PingguSoft/Mostly-Printed-CNC/doc/elec/ramps/ramps-1.4-schema-1920px.jpg

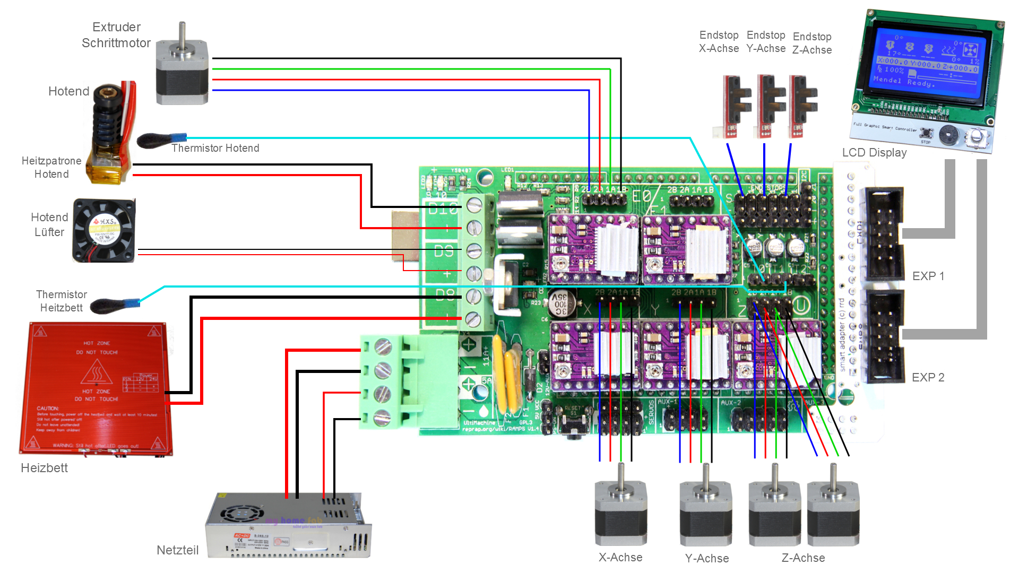
doc/elec/ramps/ramps-1.4-schema-1920px.jpg
