PingguSoft/Mostly-Printed-CNC/doc/Optimized-20151126_212913.jpg

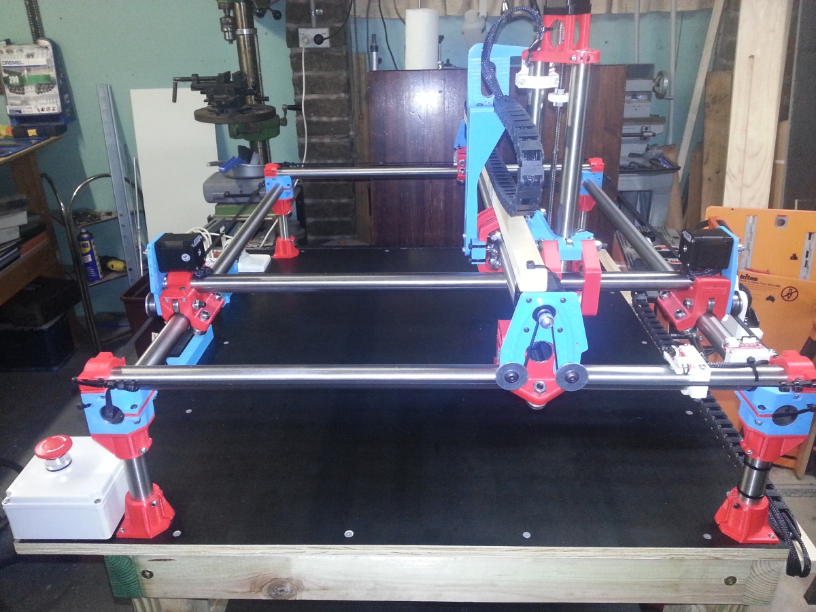
doc/Optimized-20151126_212913.jpg
