PingguSoft/Mostly-Printed-CNC/doc/corner.png

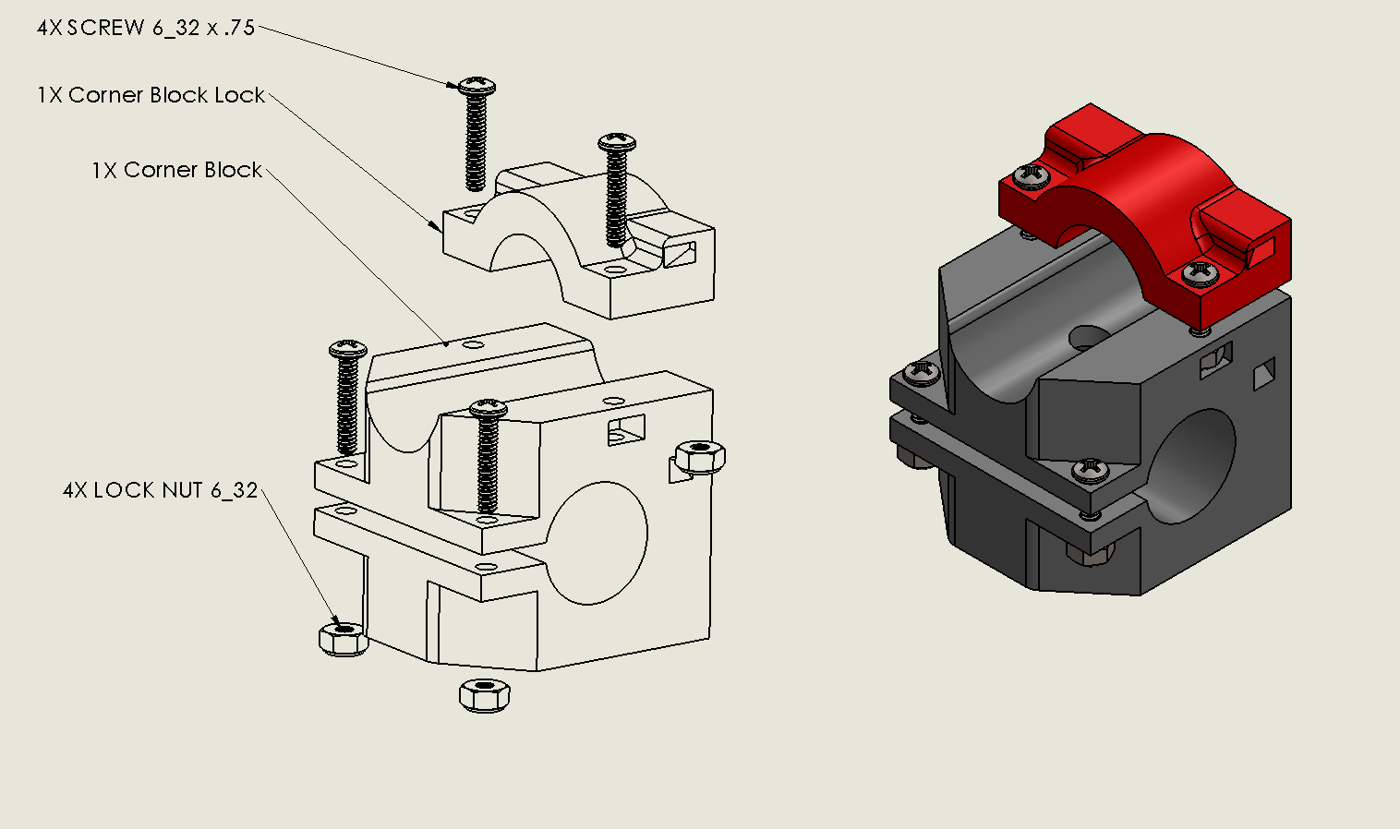
doc/corner.png
