PingguSoft/Mostly-Printed-CNC/doc/elec/laser/Elabz_TTL_Controlled_Laser_Driver.png

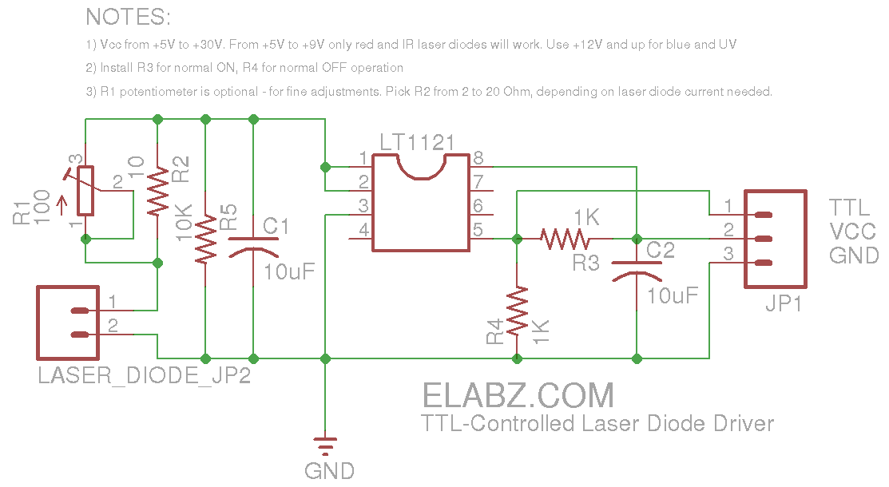
doc/elec/laser/Elabz_TTL_Controlled_Laser_Driver.png
