PingguSoft/Mostly-Printed-CNC/doc/elec/laser/laser driver2.gif

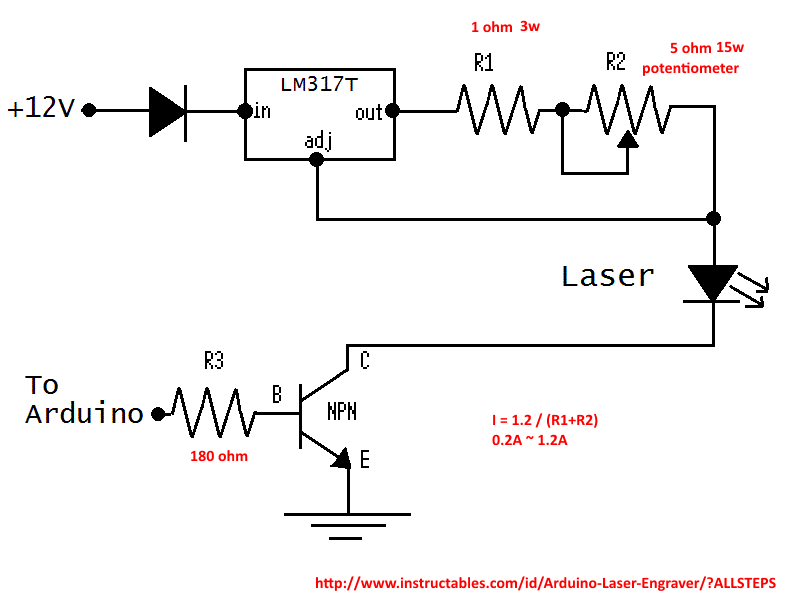
doc/elec/laser/laser driver2.gif
