PingguSoft/Mostly-Printed-CNC/doc/elec/laser/lm317.jpg

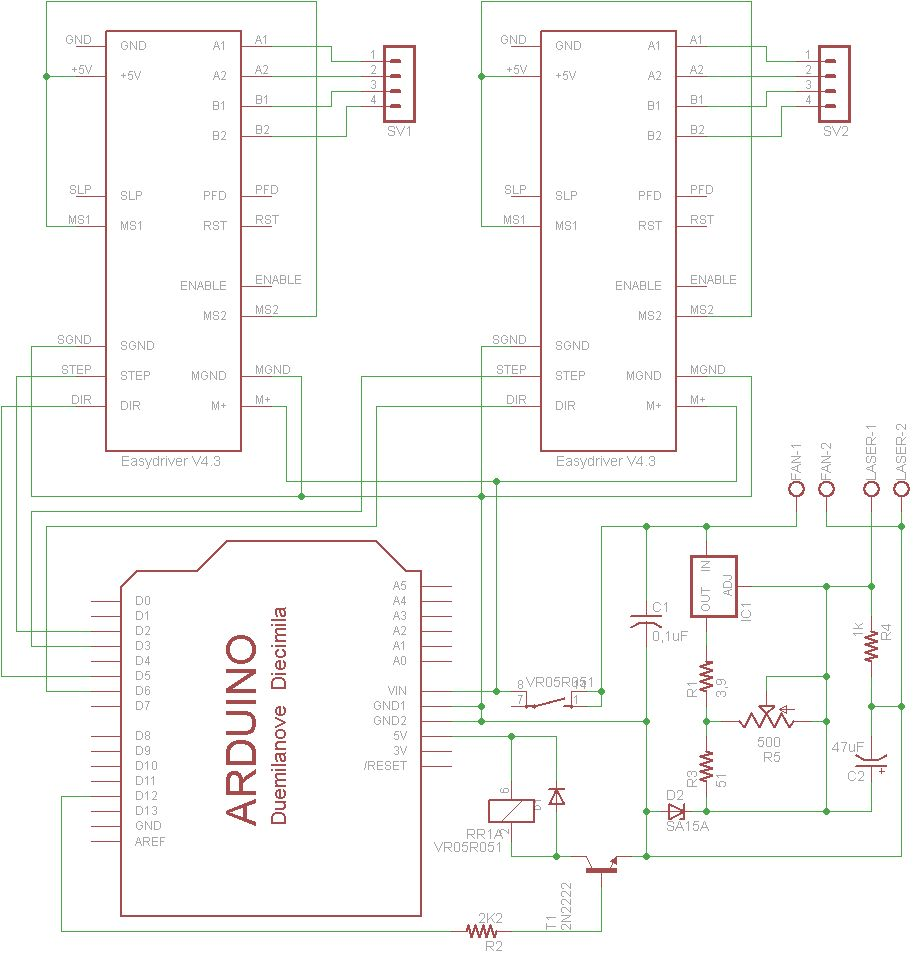
doc/elec/laser/lm317.jpg
