PingguSoft/Mostly-Printed-CNC/doc/elec/laser/Ramps-D9-voltage-divider-12v-to-4.94v-.jpg

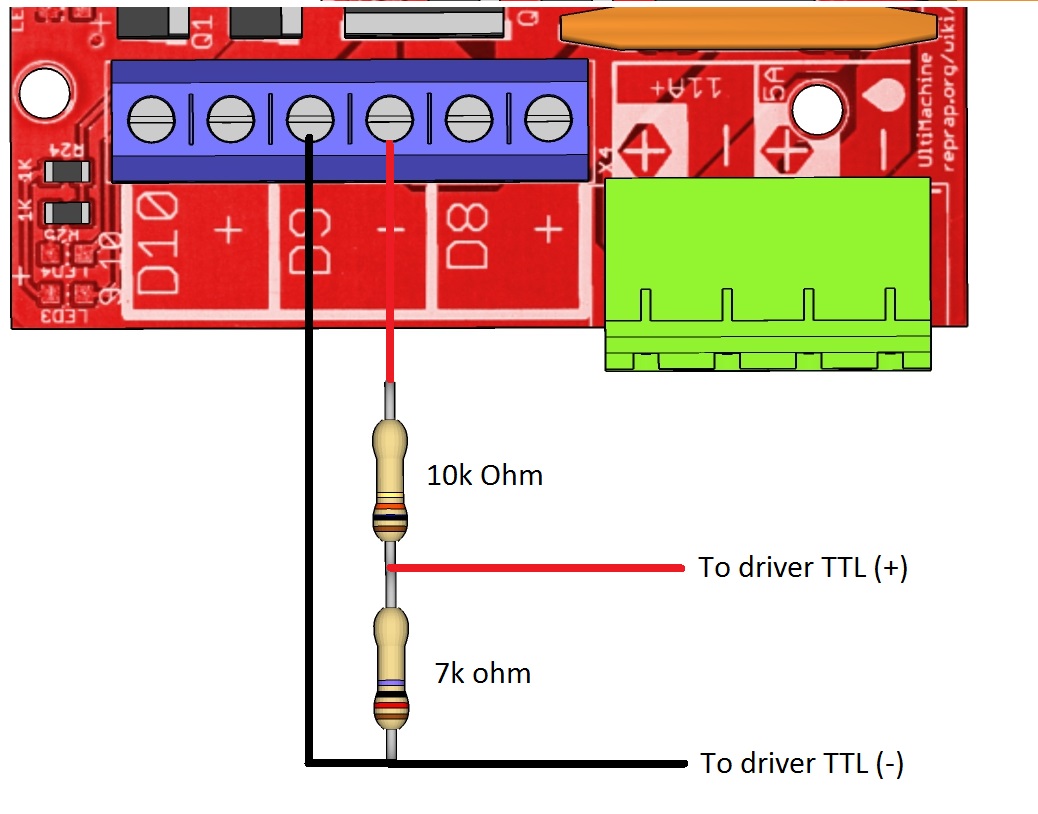
doc/elec/laser/Ramps-D9-voltage-divider-12v-to-4.94v-.jpg
