PingguSoft/Mostly-Printed-CNC/doc/elec/ramps/Motors_serial_connection.jpg

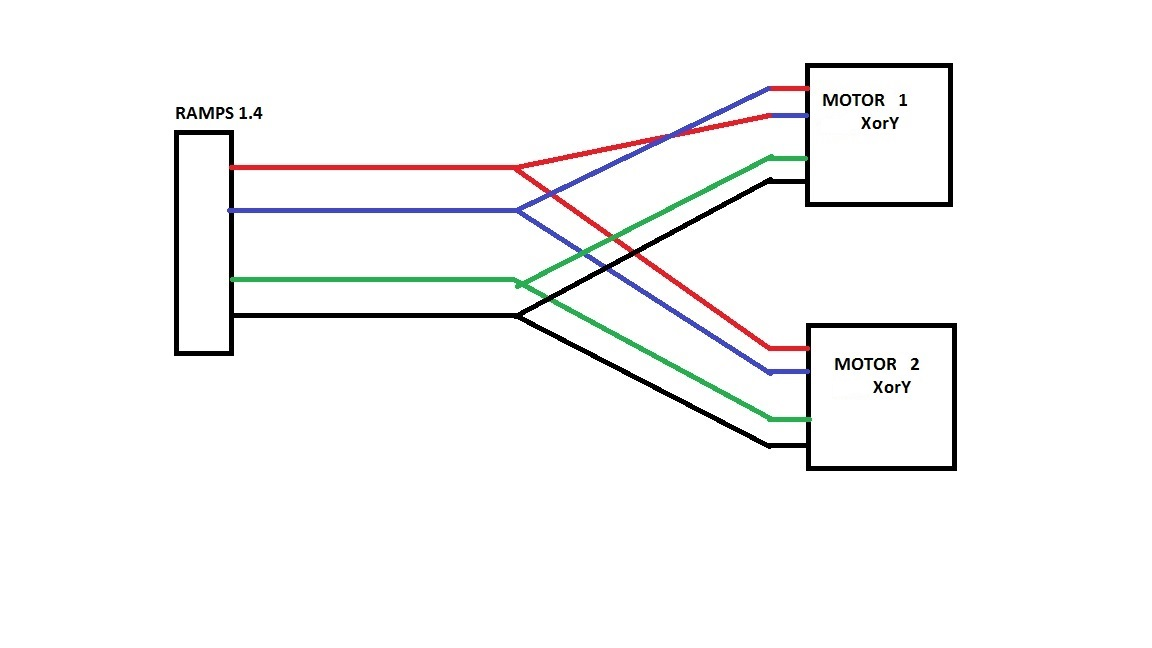
doc/elec/ramps/Motors_serial_connection.jpg
