PingguSoft/Mostly-Printed-CNC/doc/elec/ramps/ramps-1.4-connection.jpg

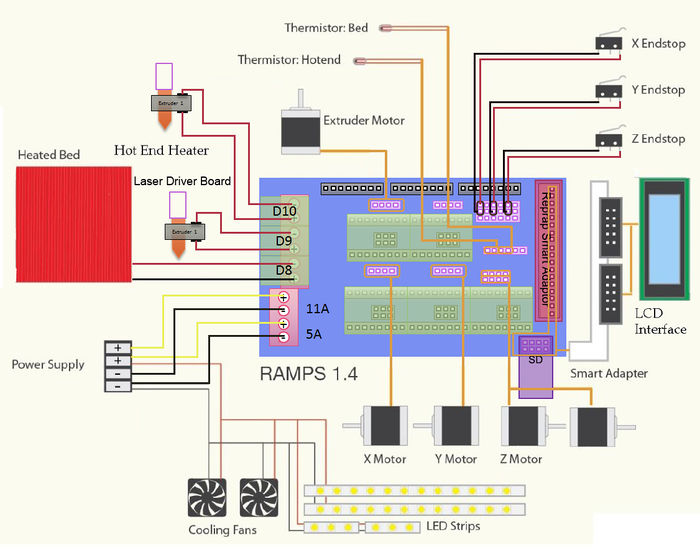
doc/elec/ramps/ramps-1.4-connection.jpg
