PingguSoft/Mostly-Printed-CNC/doc/IMG_20151024_192704.jpg

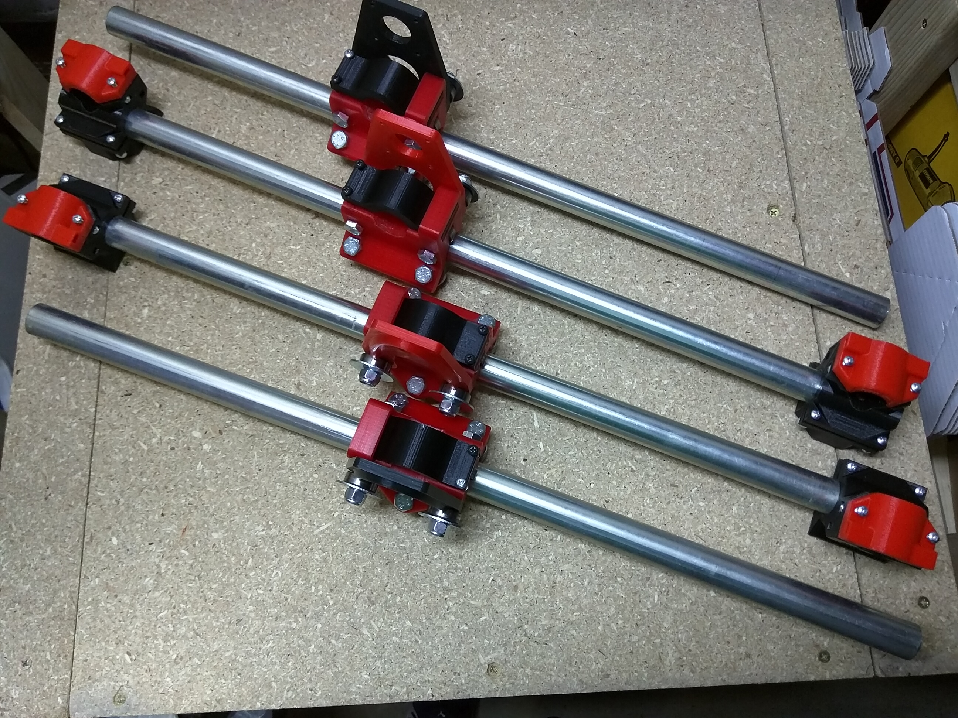
doc/IMG_20151024_192704.jpg
