PingguSoft/Mostly-Printed-CNC/doc/Milling1.jpg

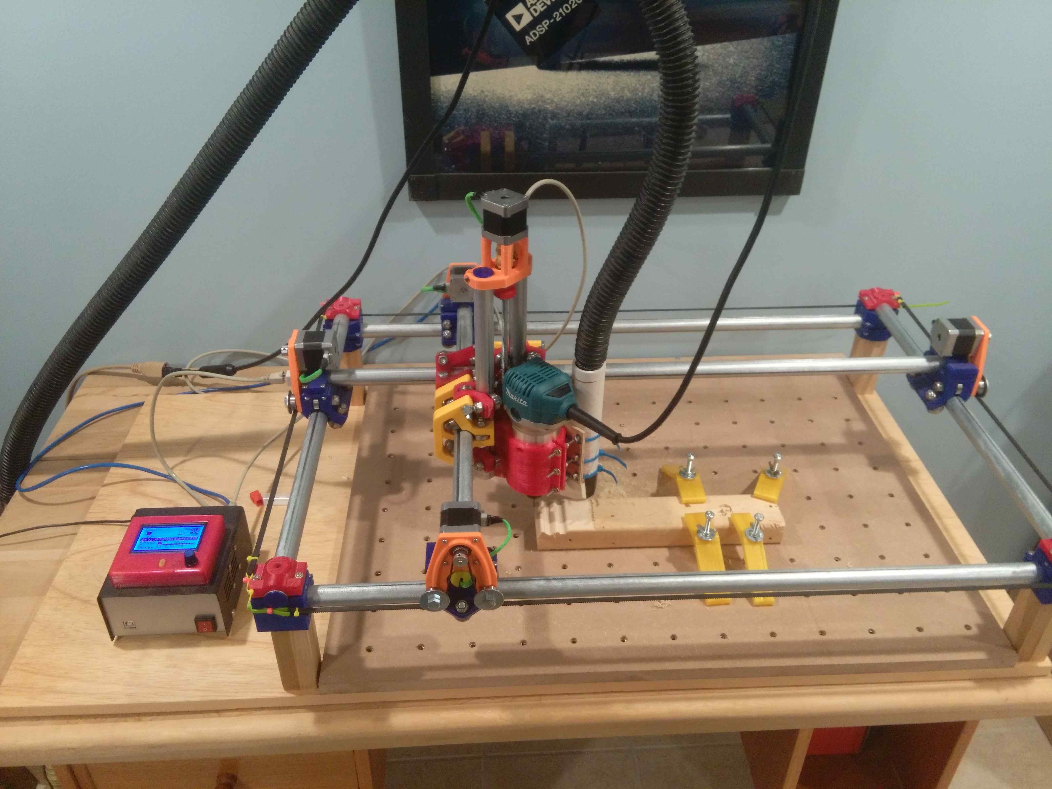
doc/Milling1.jpg
