PingguSoft/Mostly-Printed-CNC/doc/Optimized-20151126_212854.jpg

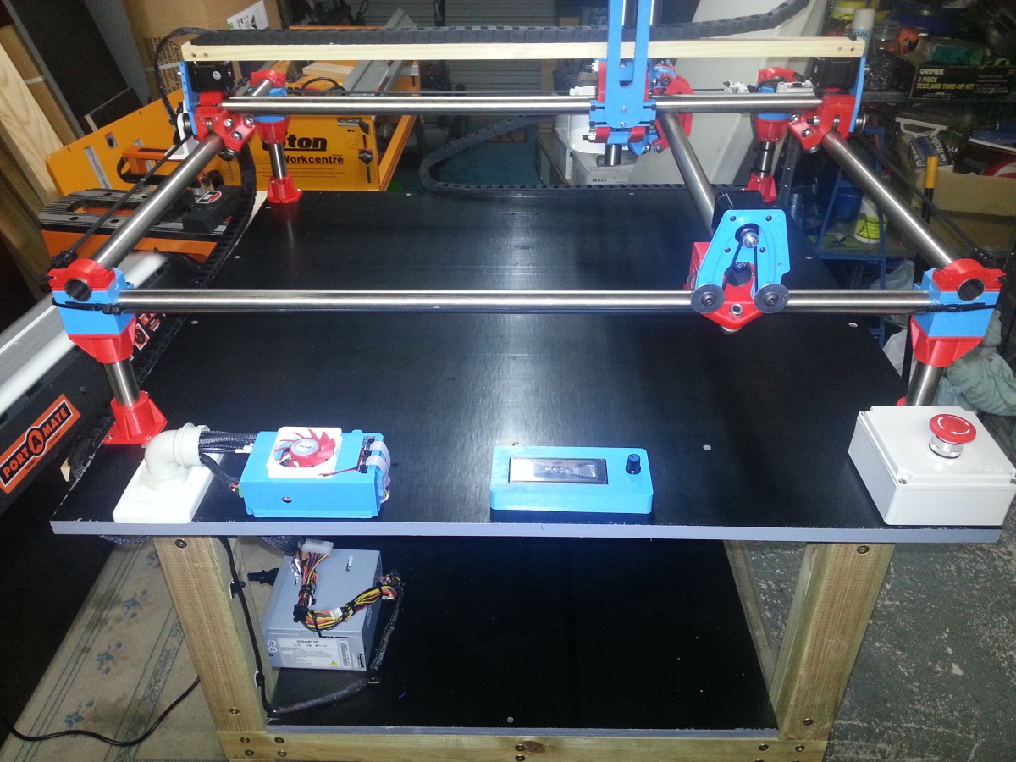
doc/Optimized-20151126_212854.jpg
