PingguSoft/Mostly-Printed-CNC/doc/Optimized-20151126_212932.jpg

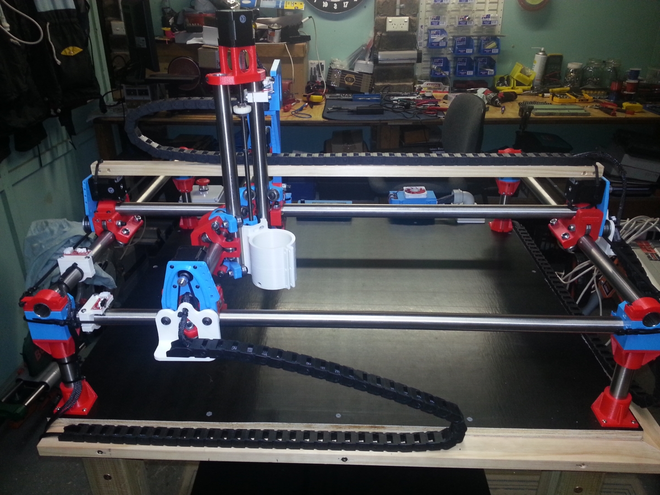
doc/Optimized-20151126_212932.jpg
