PingguSoft/Mostly-Printed-CNC/doc/Optimized-20151126_212954.jpg

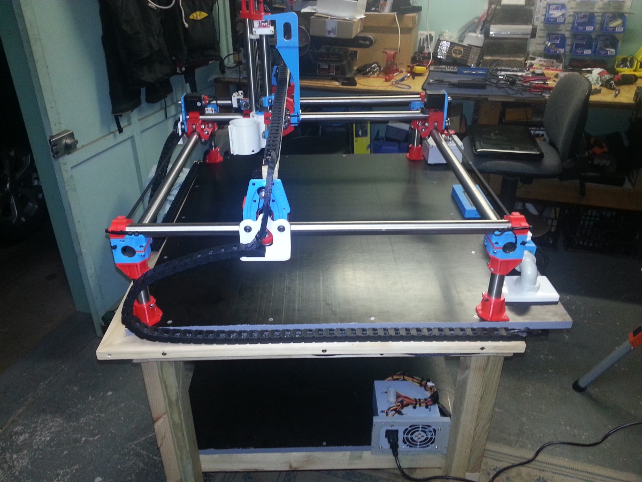
doc/Optimized-20151126_212954.jpg
