PingguSoft/Mostly-Printed-CNC/doc/roller.png

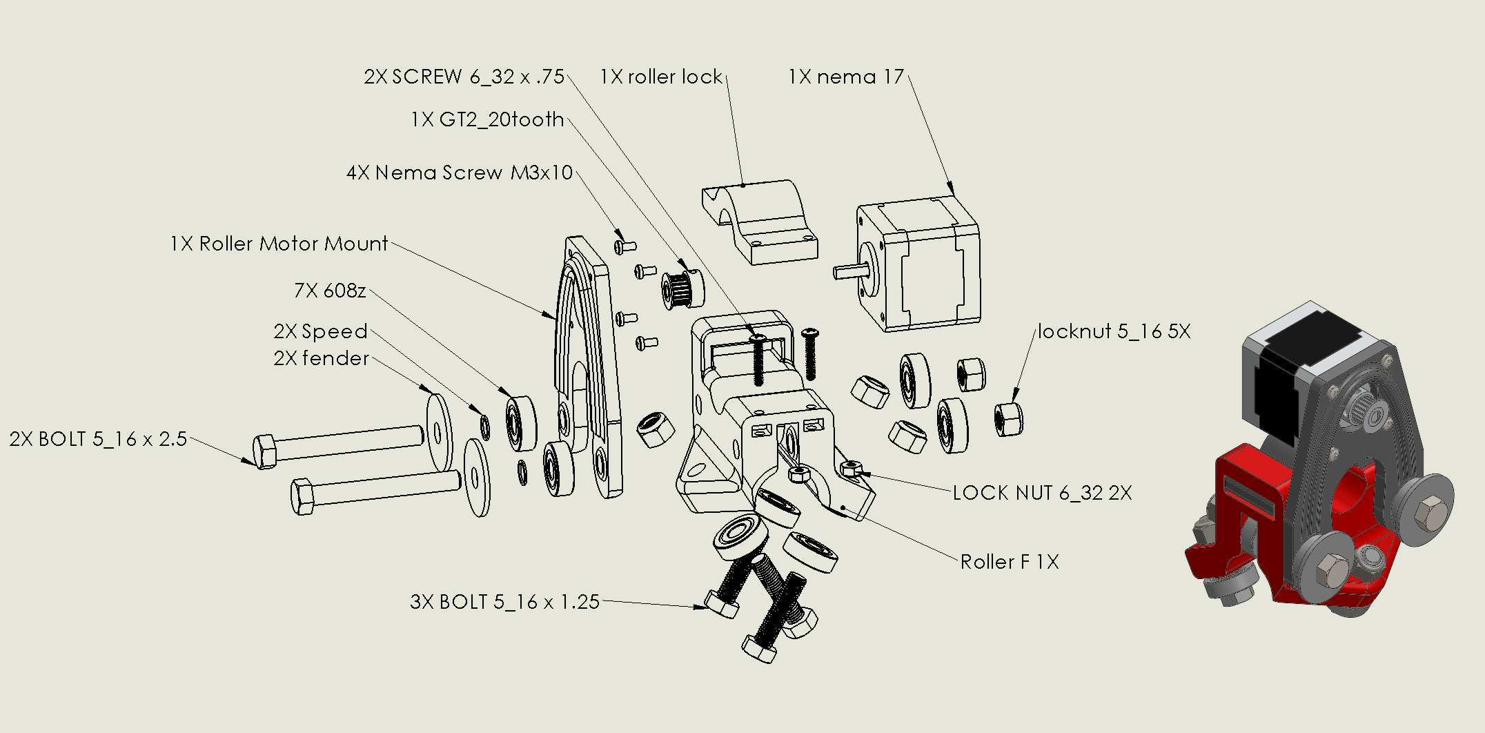
doc/roller.png
