PingguSoft/Mostly-Printed-CNC/doc/parts.xlsx

Sheet: Printed Parts
Recommended; PLA for dimension accuracy, 3 perimeters for through hole strength. I have a .4mm nozzle and print at .26mm layer height, just personal preference. I do print slow for strength, so your prints could be faster.
BLOCK | Name | QTY | Infill | 25mm Link | STL FILE | Printed
CORNER | Corner_Block2 | 4 | 40% | Link (http://www.thingiverse.com/thing:790533/) | IE_Corner_Block2.STL | V | 40%
 | Corner_Block_Lock2 | 4 | 70% | Link (http://www.thingiverse.com/thing:790533/) | IE_Corner_Block_Lock_2.STL | V | 40%
ROLLER | Roller F | 4 | 55% | Link (http://www.thingiverse.com/thing:790533/) | IE_Roller_F_25.stl | V | 40%
 | Roller Lock | 4 | 70% | Link (http://www.thingiverse.com/thing:790533/) | IE_roller_lock_25.stl | V | 40%
 | Solder-less Mount | 4 | 70% | Link (http://www.thingiverse.com/thing:823301/) | solderless_Roller_Motor_Mount.STL | V | 30%
MIDDLE | Better Middle Z | 2 | 75% | Link (http://www.thingiverse.com/thing:931550) | IE_Middle_Z_rigid_v2.STL | V | 40%
 | Middle Joiner | 2 | 70% | Link (http://www.thingiverse.com/thing:790533/) | IE_Middle_Joiner_25_V2.STL | V | 40%
 | Middle End | 2 | 70% | Link (http://www.thingiverse.com/thing:790533/) | IE_Middle_End_25_v2.STL | V | 40%
 | Z Nut Lock | 1 | 70% | Link (http://www.thingiverse.com/thing:790533) | IE_z_nut_lock_13mm.stl | V | 50%
Z Mount | Nut Trap | 2 | 50% | Link (http://www.thingiverse.com/thing:790533) | IE_Tool_Holder_Nut_Trap_25.stl | V | 50%
 | Z Motor Mount | 1 | 60% | Link (http://www.thingiverse.com/thing:806241) | IE_z_motor_mount_10mm_longer_25mm.STL | V | 40%
 | Z Knob | 1 | 50% | Link (http://www.thingiverse.com/thing:729919/) | Z_Knob.stl | V | 40%
 | ~~Rigid Coupler~~ | ~~1~~ | ~~70%~~ | ~~Link~~ (http://www.thingiverse.com/thing:790533/) | ~~IE_Rigid_Coupler_5_16_to_8mm.STL~~
 | Nasspop Coupler 5x8 | 1 |  | Link (http://nasspop.co.kr/product/detail.html?product_no=79&cate_no=85) | Rigid Coupler 대체 | V
FOOT | Flex Foot | 4 | 60% | Link (http://www.thingiverse.com/thing:902483/) | IE-Flex_Foot.STL | V | 40%
 | Foot Bottom | 4 | 60% | Link (http://www.thingiverse.com/thing:902483/) | IE_Foot_Bottom.stl | V | 40%
ETCS | Belt clip | 8 | 40% | Link (http://www.thingiverse.com/thing:1272787) | riemenhalter.stl | V | 30%
 | End stops | 1 | 40% | Link (http://www.thingiverse.com/thing:1090453) | IE25mm-A-endstops_XY.stl IE25mm-B-endstops_Z.stl | V | 30%
 | RepRapDiscount Full Graphic Smart Controller | 1 | 40% | Link (http://www.thingiverse.com/thing:617468) | mods_for_display_case_button.stl | V | 30%
 |  | 1 | 40% | Link (http://www.thingiverse.com/thing:617468) | mods_for_display_case_front.stl | V | 30%
 |  | 1 | 40% | Link (http://www.thingiverse.com/thing:617468) | mods_for_display_case_back.stl | V | 30%
 | drag chain holder for XY-axis | 1 | 50% | Link (http://www.thingiverse.com/thing:1272581) | MPCNCdragchain.stl | V | 30%
 | drag chain / cable carrier for Z axis | 1 | 50% | Link (http://www.thingiverse.com/thing:1296042) | MPCNCdragchainXclip.stl | V | 30%
 |  | 1 | 50% |  | MPCNCdragchainZclip.stl | V | 30%
 |  | 1 | 50% |  | MPCNCdragchainZshelf.stl | V | 30%
UNIVERSAL MOUNT & TOOL HOLDER (HicWic) | ~~Tool Holder V2~~ | ~~2~~ | ~~70%~~ | Link (http://www.thingiverse.com/thing:790533) | IE_Tool_Holder_13mm_25.stl
 | Universal Mount | 1 | 70% | Link (http://www.thingiverse.com/thing:1234989) | IE_Universal_Mount_v5.stl | V | 40%
 | Pen Holder | 1 | 70% | Link (http://www.thingiverse.com/thing:1235003) | Pen_Holder_v4.stl | V | 30%
 |  | 1 | 70% | Link (http://www.thingiverse.com/thing:1235003) | Pen_Adapter_10.5mm.stl | V | 30%
 | MK8 Holder | 1 | 70% | Link (http://www.thingiverse.com/thing:1237075) | TKY_MPCNC_UniversalMount_Mk8_slider.stl
 |  | 1 | 70% |  | TKY_MPCNC_UniversalMount_Mk8_bracket.stl | V | 40%
 |  | 1 | 70% |  |  | V | 40%
 | Dremel 300 Holder | 1 | 70% | Link (http://www.thingiverse.com/thing:1236957) | Dremel300_UpperBracket.stl
 |  | 1 | 70% |  | Dremel300_Bottom_w_Mount.stl
 | Laser holder | 1 | 70% |  | holder.stl | V | 40%
 | Roland Drag Knife Holder | 1 | 70% | Link (http://www.thingiverse.com/thing:1252975)

Sheet: Electronics & Motion Parts
Part | Link | Qty | unit price | Price | Purchased | Price | Remark
Ramps 1.4 Shield | http://nasspop.co.kr/product/detail.html?product_no=75&cate_no=63&display_group=1 | 1 | ₩8500 | ₩8500 | 0 | ₩0 | reused
Arduino Mega 2560 | http://nasspop.co.kr/product/detail.html?product_no=77&cate_no=63&display_group=1 | 1 | ₩15000 | ₩15000 | 0 | ₩0 | reused
DRV8825 Drivers + Heat Sinks | http://nasspop.co.kr/product/detail.html?product_no=103&cate_no=63&display_group=1 | 4 | ₩2900 | ₩11600 | 3 | ₩8700 | reused
12v 5A power supply | http://nasspop.co.kr/product/detail.html?product_no=132&cate_no=75&display_group=1 | 1 | ₩14000 | ₩14000 | 0 | ₩0 | reused
GT2 belt (4M = 24″x24″) | http://nasspop.co.kr/product/detail.html?product_no=25&cate_no=71&display_group=1 | 4 | ₩1500 | ₩6000 | 4 | ₩6000
GT2 16T Pulley | http://nasspop.co.kr/product/detail.html?product_no=26&cate_no=71&display_group=1 | 4 | ₩1500 | ₩6000 | 4 | ₩6000
608 Bearings (2-RS, Z, ZZ) | http://nasspop.co.kr/product/detail.html?product_no=47&cate_no=72&display_group=1 | 60 | ₩200 | ₩12000 | 60 | ₩12000
Conduit 3/4″ emt (23.5mm OD, IE version 25mm OD) | http://www.11st.co.kr/product/SellerProductDetail.tmall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 | 1 | ₩23400 | ₩23400 | 1 | ₩23400
Nema 17 Steppers | http://nasspop.co.kr/product/detail.html?product_no=18&cate_no=62&display_group=1#none | 5 | ₩15500 | ₩77500 | 3 | ₩46500 | 2 reused
12864 GLCD | http://nasspop.co.kr/product/detail.html?product_no=89&cate_no=63&display_group=1 | 1 | ₩15000 | ₩15000 | 1 | ₩15000
Resistor 100 ohm
Stranded Shielded 4 Wire |  | ≅15ft
DuPont connectors (3×4 & 1×2) |  | 4
Zip Ties |  | ≥20
 |  |  |  | ₩189000 |  | ₩117600
Spindle Options
Dewalt 660 (Beast!) | http://amzn.to/1VyeDY6 | 1
or Dremel 300 |  | 1 |  |  | 0 |  | reused
3D Printer Options
3D printer extruder | http://www.aliexpress.com/item/12-24V-Fan-3D-Printer-head-Makerbot-3D-Printer-single-exturder-MK8-Extruder-Free-Shipping/1987122502.html | 1 | ₩31536 | ₩31536 | 1 | ₩31536
Laser Options
500mw 405NM focusing blue purple laser module laser engraving TTL module | http://www.aliexpress.com/item/500mw-405NM-focusing-blue-purple-laser-module-laser-engraving-TTL-module-500mw-laser-tube-Laser-module/32562052620.html | 1 | ₩46200 | ₩46200 | 0 | ₩0
Roland Drag Knife Options
Gcc Sign pal Vinyl Cutter Blade Holder + 5 pcs 45 + 5 pcs 60 Degree | http://www.aliexpress.com/item/1pc-Gcc-Signpal-Vinyl-Cutter-Blade-Holder-5-pcs-45-5-pcs-60-Degree-Roland-Liyu/32336073909.html | 1 | ₩20388 | ₩20388 | 0 | ₩0
 |  |  |  | ₩98124 |  | ₩31536
 |  |  | TOTAL | ₩287124 |  | ₩149136

Sheet: Hardware
Sort | Imperial | Metric | Link | Qty | Qty/pack | pack | unit price | Price | Purchased |  |  |  |  | 개수
TR | 5/16-18 Threaded Rod | M8 | http://nasspop.co.kr/product/detail.html?product_no=152&cate_no=87&display_group=1 | 1 | 440mm | 1 | ₩1500 | ₩1500 | V |  |  | mm |  |  |  |  |  | Cm | inch
HEX BOLT | 5/16-18 X 3 | M8 X 80 | http://www.11st.co.kr/product/SellerProductDetail.tmall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 | 4 | 7 | 1 | ₩1500 | ₩1500 | V | working area | x | 400 |  |  |  | working area | x | 40 | 15.7480315
 | 5/16-18 X 2.5 | M8 X 70 |  | 8 | 9 | 1 | ₩1500 | ₩1500 | V |  | y | 400 |  |  |  |  | y | 40 | 15.7480315
 | 5/16-18 X 1.75 | M8 X 45 |  | 2 | 10 | 1 | ₩1500 | ₩1500 | V |  | z | 140 |  |  |  |  | z | 25 | 9.842519685
 | 5/16-18 X 1.5 | M8 X 40 |  | 2 | 12 | 1 | ₩1500 | ₩1500 | V
 | 5/16-18 X 1.25 | M8 X 30 |  | 28 | 16 | 2 | ₩3000 | ₩6000 | V | Conduit length | x | 664 |  | 3 | 1992 | Conduit length | x | 67 | 26.37795276 | 3 | 201
WASHER | 5/16 Fender Washers | M8 - 30 | http://www.11st.co.kr/product/SellerProductDetail.tmall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 | 8 | 14 | 1 | ₩1500 | ₩1500 | V |  | y | 664 |  | 3 | 1992 |  | y | 67 | 26.37795276 | 3 | 201
 | SAE(Small washer) or Speed washers | M8 | http://www.11st.co.kr/product/SellerProductDetail.tmall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 | 8 | 55 | 1 | ₩1500 | ₩1500 | V |  | z | 330 |  | 2 | 660 |  | z | 45 | 17.71653543 | 2 | 90
NUTS | 5/16-18 Nylock Nuts | M8 | http://www.11st.co.kr/product/SellerProductDetail.tmall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 | 44 | 25 | 2 | ₩3000 | ₩6000 | V |  | leg | 127 |  | 4 | 508 |  | leg | 25 |  | 4 | 100
 | 5/16-18 nuts (2 for z knob) | M8 |  | 3 | 37 | 1 | ₩1500 | ₩1500 | V |  |  |  |  |  | 5152 |  |  |  |  |  | 592
 | #6-32 Nylock nuts | M4 |  | 36 | 67 | 1 | ₩1500 | ₩1500 | V | Thread | z | 216 | min | ~250 |  | Thread | z | 39.92 | 15.71653543
CROSS BOLT | M3 X 10 | M3 X 10 | http://www.11st.co.kr/product/SellerProductDetail.tmall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 | 20 | 42 | 1 | ₩1500 | ₩1500 | V
 | #6-32 X.75 | M4 X 20 |  | 34 | 20 | 2 | ₩3000 | ₩6000 | V | belt | x | 800 | min | 2 |  |  |  | mm | Cm | 개수
 | #6-32 X .5 for coupler (20 for solderless mounts) | M4 X 16 |  | 22 | 25 | 1 | ₩1500 | ₩1500 | V |  | y | 800 | min | 2 |  | 조인트 차지하는 길이 |  | 27
ETCS | 5/16 x 7/8 coupling nut | M8 X 25 |  | 1 |  | 1 |  |  |  |  |  |  |  |  |  | 지지 파이프 길이 |  | 616 | 62 | 4 | 248
 | Spring 1″X.375″ODx.035″ | M8IDX25mmX.9mm |  | 1 |  | 1 |  |  |  | table | x | 670.5 | min |  |  | leg |  |  | 13 | 4 | 52
CHAINS | drag chain | 10x20mm x 1m | AliExpress (http://www.aliexpress.com/item/10-x-20mm-1M-Open-On-Both-Side-Plastic-Towline-Cable-Drag-Chain-Wonderful-Gift/32244468731.html) | 4 | 1 | 4 | ₩5424 | ₩21696 | V |  | y | 670.5 | min |  |  |  |  |  |  |  | 300
GLASS | tempered glass | 450mmx450mm | http://www.11st.co.kr/product/SellerProductDetail.tmall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 | 1 |  | 1 | ₩9900 | ₩9900 | V
TABLE | MELLTORP 테이블 상판(제품번호: 302.800.99) | 750mmx750mm | http://www.ikea.com/kr/ko/catalog/products/30280099/ | 1 |  | 1 | ₩19900 | ₩19900 | V
PIPE JOINT | L 형 조인트 |  | http://www.11st.co.kr/product/SellerProductDetail.tmall?method=getSellerProductDetail&prdNo=1300741891 | 4 |  |  | ₩3710 | ₩14840
 | 원형 롱소켓 |  |  | 4 |  |  | ₩1710 | ₩6840
 | 돔형 마감캡 |  |  | 12 |  |  | ₩500 | ₩6000
SUPPORT | 지지 파이프 | 25mm | http://www.11st.co.kr/product/SellerProductDetail.tmall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
 |  |  |  |  |  |  |  | ₩113676

Sheet: Connector
MODULE | PART | PIN | POWER | OTHERS
3D Printer Extruder | Stepper Motor | 4 | 4 | 6 | 1 | 2 | 3 | 4 | 5 | 6 | 7 | 8 | 9 | 10 | 1 | 2 | 3 | 4 | 5 | 6
 | Thermal sensor | 2 |  |  | E-STP1 | E-STP2 | E-STP3 | E-STP4 | N-Therm | N-Therm | Z-END |  |  |  | +12V PC | +12V HC | +12V AO | 5V |  | GND
 | 12V AO(always on, 5A) for barrel FAN | 1 |  |  | 오렌지 | 옅은녹색 | 녹색 | 흰색 | 갈색 | 연한갈색 | 연한파랑 |  |  |  | 녹색 | 파랑 | 보라 | 파랑 |  | 회색
 | 12V PC(pwm controlled) for hotend FAN | 1 |  |  |  |  |  |  |  |  | active high
 | 12V HC for hotend | 1 |  |  | Cat-6 | twisted
 | GND | 1
Laser | 12V AO(always on, 5A) | 1 | 2 | 1
 | GND | 1 |  |  | MOLEX 53258-06 |  | MALE | ₩290 | 5 | ₩1450 |  |  | z axis side
 | PWM | 1 |  |  | MOLEX 51067-06 |  | FEMALE | ₩390 | 5 | ₩1950 |  |  | tool side
 |  |  |  |  | 51067 Crimp terminal |  |  | ₩50 | 30 | ₩1500
Z endstop | sensor | 2 | 0 | 2 | MOLEX 5566-06A |  | MALE | ₩510 | 5 | ₩2550 |  |  | Z axis side
 |  |  |  |  | MOLEX 5557-06R |  | FEMALE | ₩210 | 5 | ₩1050 |  |  | tool side
 |  |  |  |  | 5557 Crimp terminal |  |  | ₩50 | 30 | ₩1500
 |  |  |  |  |  |  |  |  |  | ₩10000

Sheet: assemble_cornor_block
https://youtu.be/g01UwQhFxdI

Sheet: assemble_roller
https://youtu.be/mri-6v6uIMo

Sheet: assemble_z_mount
https://youtu.be/Apgp4XfpfwM

Sheet: assemble_middle
http://www.vicious1.com/assembly/middle/
