PingguSoft/Mostly-Printed-CNC/stl/etcs/connector_holder_base.stl

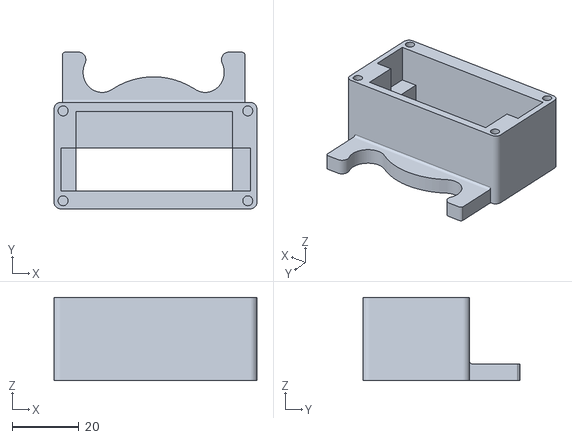
[picture p19: CAD file, 2017-01-20]
stl/etcs/connector_holder_base.stl
61.0 x 47.1 x 25.0
