PingguSoft/Mostly-Printed-CNC/stl/foot/IE-Flex_Foot.STL

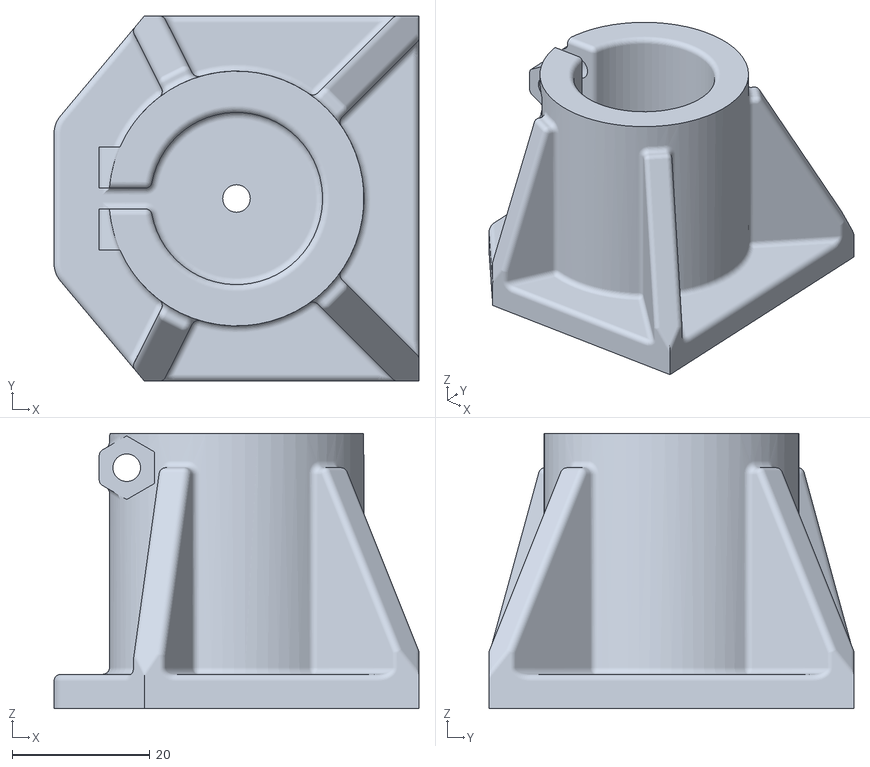
[picture p20: CAD file, 2016-01-13]
stl/foot/IE-Flex_Foot.STL
53.0 x 53.0 x 40.0
