PingguSoft/Mostly-Printed-CNC/stl/IE_Middle_Z_rigid_v2.STL

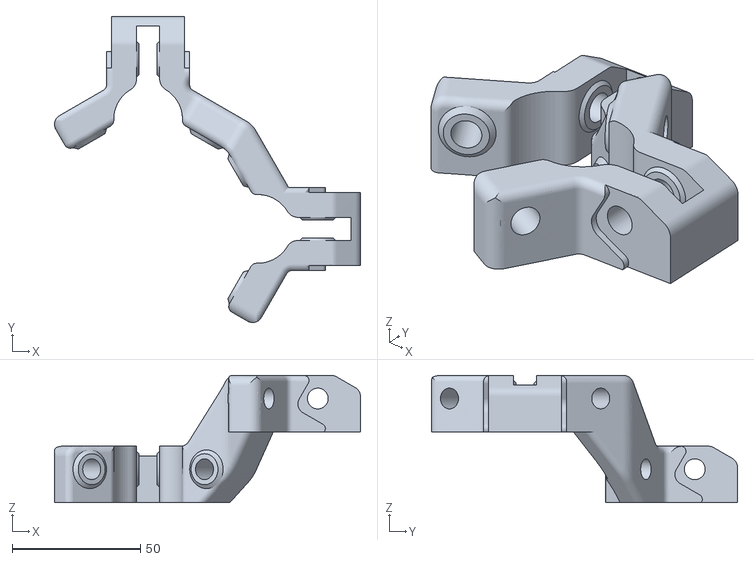
[picture p21: CAD file, 2016-01-13]
stl/IE_Middle_Z_rigid_v2.STL
119.4 x 119.4 x 49.6
