PingguSoft/Mostly-Printed-CNC/stl/spool/pipe_cap_for_25mm.stl

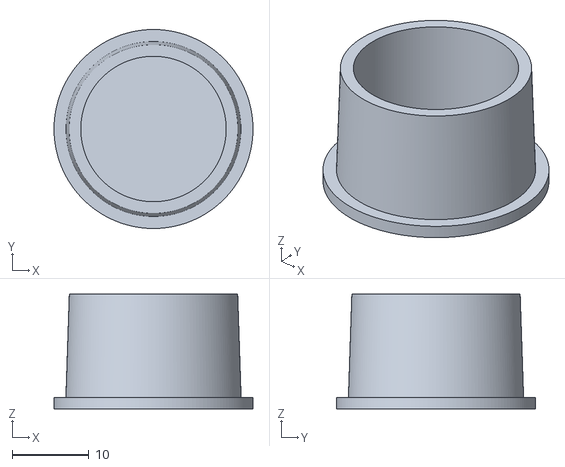
[picture p22: CAD file, 2017-01-20]
stl/spool/pipe_cap_for_25mm.stl
26.0 x 26.0 x 15.0
