PingguSoft/Mostly-Printed-CNC/stl/universal holder/Std_Mini_Mount_v4.stl

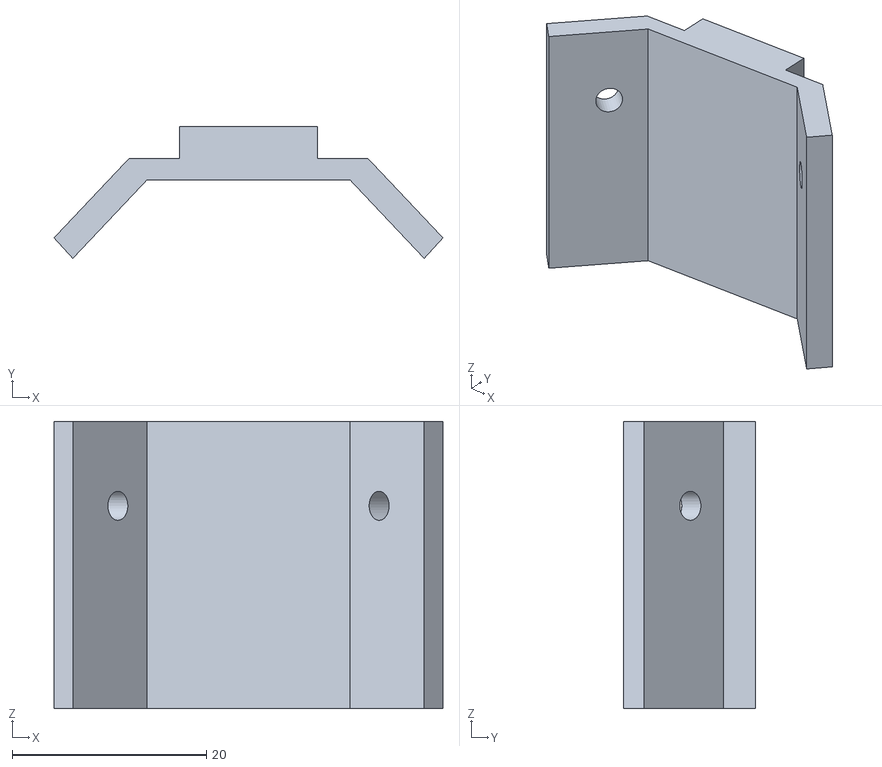
[picture p23: CAD file, 2016-02-04]
stl/universal holder/Std_Mini_Mount_v4.stl
40.1 x 13.6 x 29.6
