PingguSoft/Mostly-Printed-CNC/stl/etcs/sensor_holder_all.stl

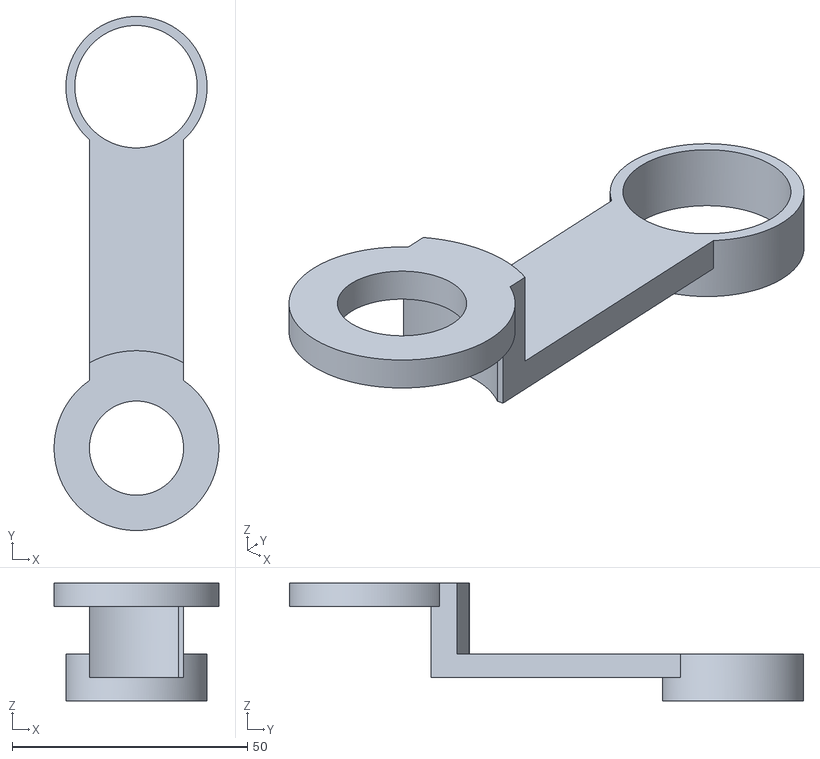
[picture p24: CAD file, 2017-01-20]
stl/etcs/sensor_holder_all.stl
35.0 x 109.2 x 25.0
