PingguSoft/Mostly-Printed-CNC/stl/foot/IE_Foot_Bottom.stl

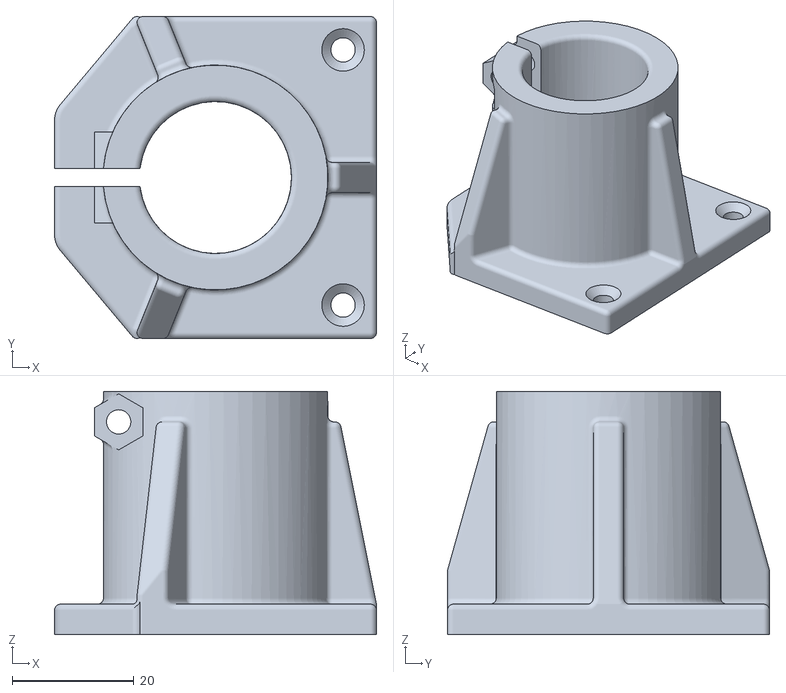
[picture p25: CAD file, 2016-01-13]
stl/foot/IE_Foot_Bottom.stl
53.0 x 53.0 x 40.0
