PingguSoft/Mostly-Printed-CNC/stl/universal holder/Offset10mm_Maxi_Mount_v2.stl

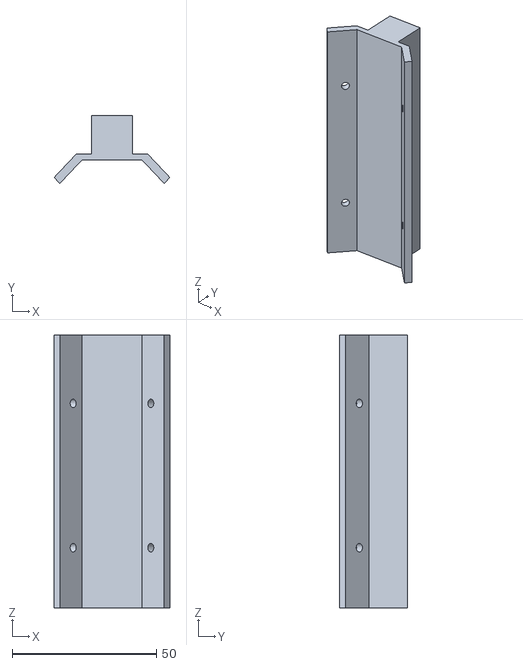
[picture p26: CAD file, 2016-02-04]
stl/universal holder/Offset10mm_Maxi_Mount_v2.stl
40.1 x 23.6 x 94.6
