PingguSoft/Mostly-Printed-CNC/stl/etcs/spool_holder.stl

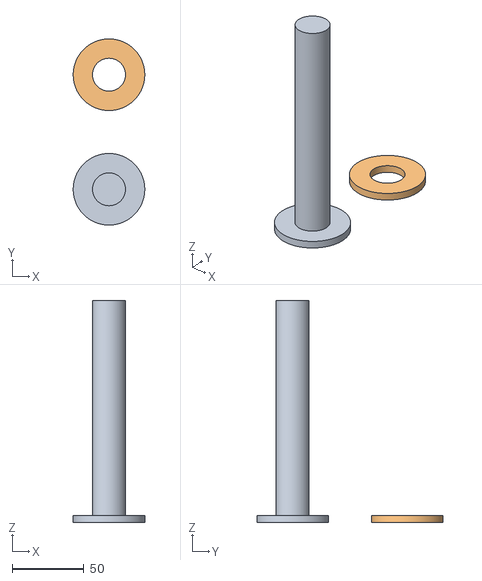
[picture p27: CAD file, 2017-01-20]
stl/etcs/spool_holder.stl
50.0 x 130.0 x 155.0
