PingguSoft/Mostly-Printed-CNC/stl/solderless_Roller_Motor_Mount.STL

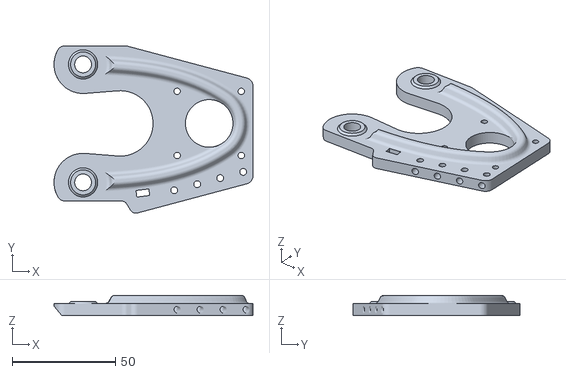
[picture p28: CAD file, 2016-01-13]
stl/solderless_Roller_Motor_Mount.STL
96.1 x 80.9 x 9.84
