PingguSoft/Mostly-Printed-CNC/stl/spool/2016_spool.stl

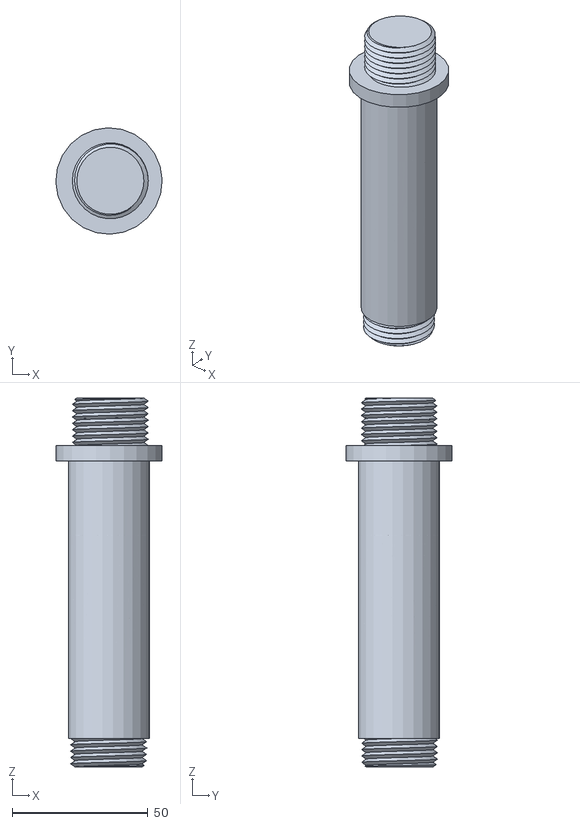
[picture p29: CAD file, 2017-01-20]
stl/spool/2016_spool.stl
39.2 x 39.2 x 135.8
