PingguSoft/Mostly-Printed-CNC/stl/universal holder/Dremel300_UpperBracket.stl

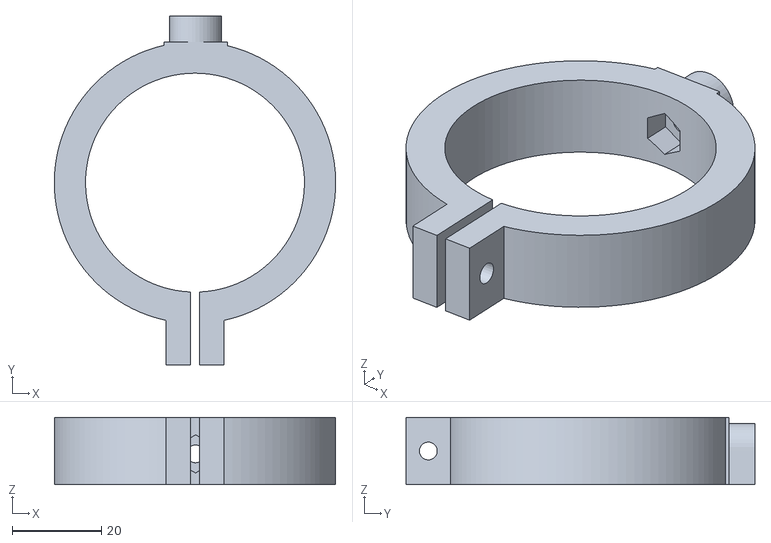
[picture p30: CAD file, 2016-01-22]
stl/universal holder/Dremel300_UpperBracket.stl
63.0 x 78.1 x 15.0
