PingguSoft/Mostly-Printed-CNC/stl/etcs/connector_holder_top.stl

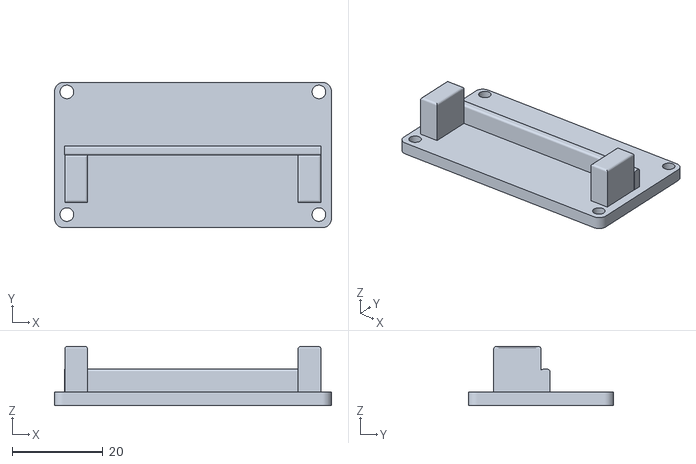
[picture p31: CAD file, 2017-01-20]
stl/etcs/connector_holder_top.stl
61.0 x 32.0 x 13.0
