PingguSoft/Mostly-Printed-CNC/stl/IE_z_motor_mount_10mm_longer_25mm.STL

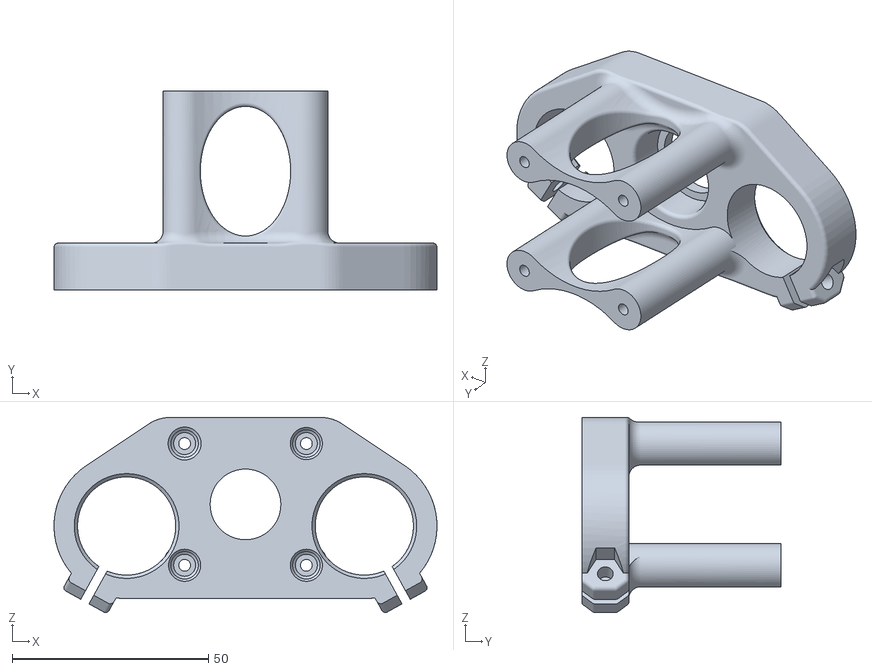
[picture p32: CAD file, 2016-01-13]
stl/IE_z_motor_mount_10mm_longer_25mm.STL
97.5 x 50.8 x 49.7
