PingguSoft/Mostly-Printed-CNC/stl/universal holder/Dremel300_Bottom_w_Mount.stl

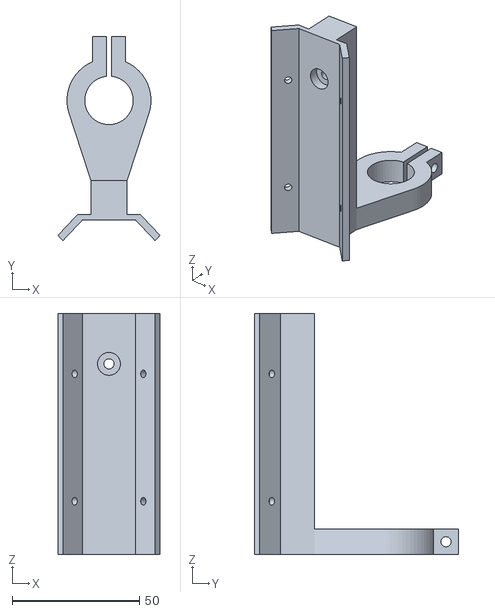
[picture p33: CAD file, 2016-01-22]
stl/universal holder/Dremel300_Bottom_w_Mount.stl
40.1 x 80.3 x 94.6
