PingguSoft/Mostly-Printed-CNC/stl/etcs/Felix_E3DV5_fan_duct_V2.stl

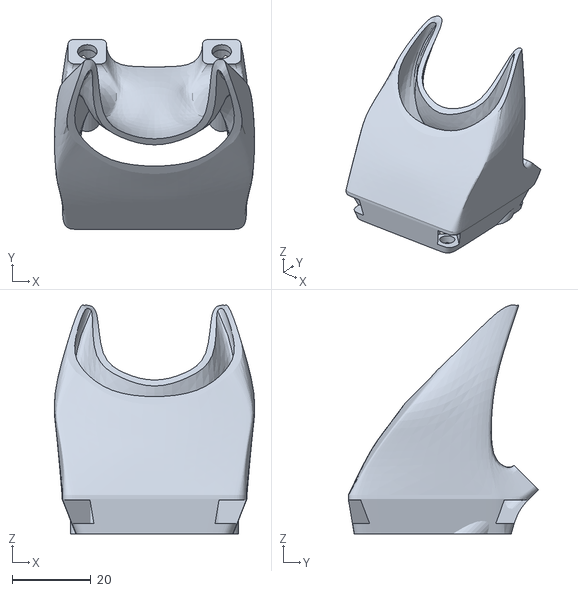
[picture p34: CAD file, 2017-01-20]
stl/etcs/Felix_E3DV5_fan_duct_V2.stl
51.0 x 48.5 x 58.3
