PingguSoft/Mostly-Printed-CNC/stl/universal holder/Pen_Holder_v4.stl

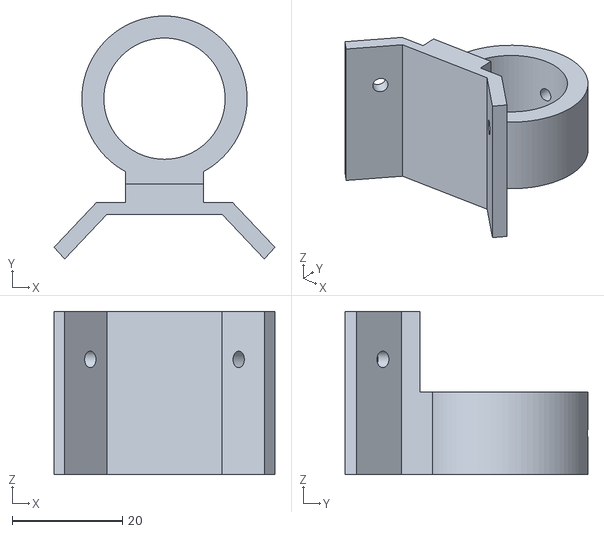
[picture p35: CAD file, 2016-01-20]
stl/universal holder/Pen_Holder_v4.stl
40.1 x 44.1 x 29.6
