PingguSoft/Mostly-Printed-CNC/stl/Z_Knob.STL

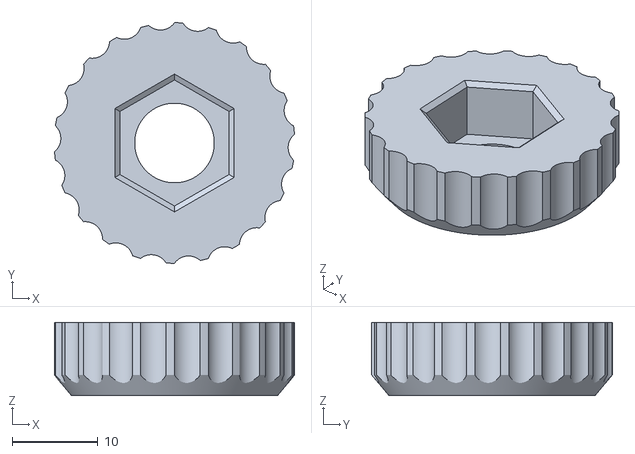
[picture p36: CAD file, 2016-01-13]
stl/Z_Knob.STL
27.9 x 28.0 x 8.50
