PingguSoft/Mostly-Printed-CNC/stl/etcs/mpcnc_square_check_rev1_20160212-15074-5me4b8-0.stl

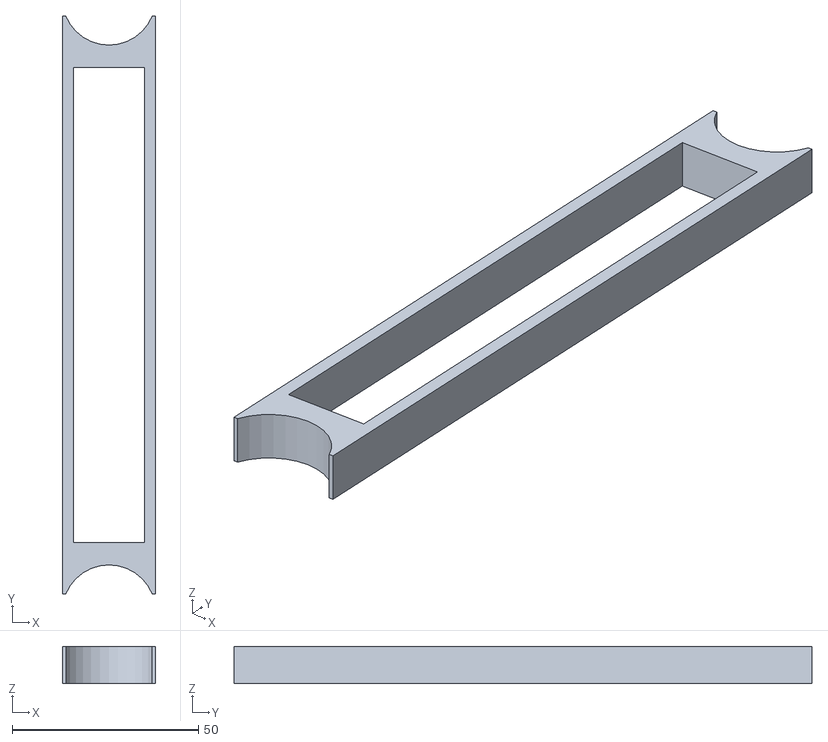
[picture p37: CAD file, 2017-01-20]
stl/etcs/mpcnc_square_check_rev1_20160212-15074-5me4b8-0.stl
25.0 x 155.0 x 10.0
