PingguSoft/Mostly-Printed-CNC/stl/IE_roller_lock_25.stl

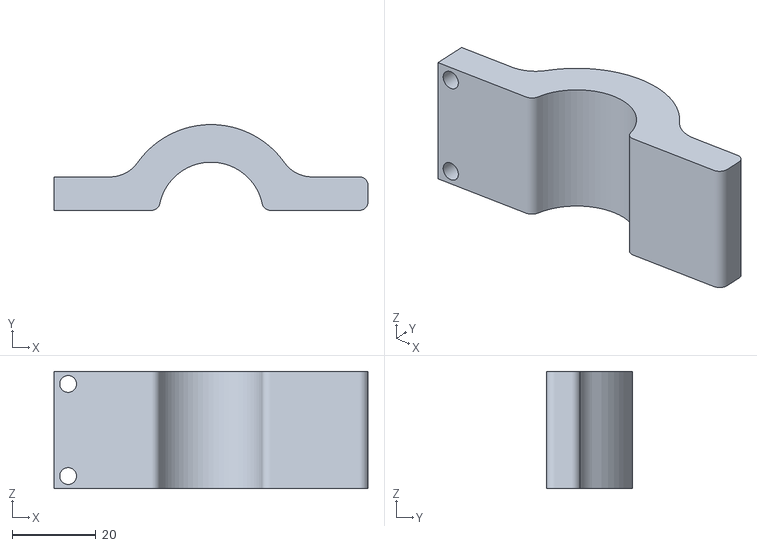
[picture p38: CAD file, 2015-11-30]
stl/IE_roller_lock_25.stl
75.0 x 20.5 x 28.0
