PingguSoft/Mostly-Printed-CNC/stl/universal holder/Pen_Adapter_10.5mm.stl

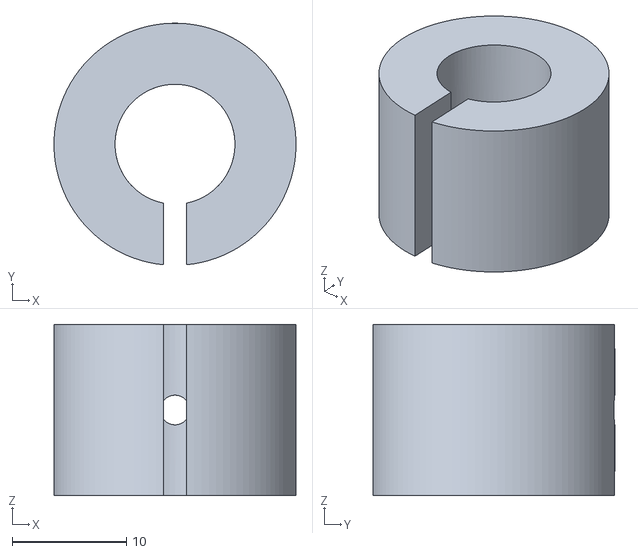
[picture p39: CAD file, 2016-01-20]
stl/universal holder/Pen_Adapter_10.5mm.stl
21.2 x 21.2 x 15.0
