PingguSoft/Mostly-Printed-CNC/stl/etcs/MPCNCdragchainZclip.stl

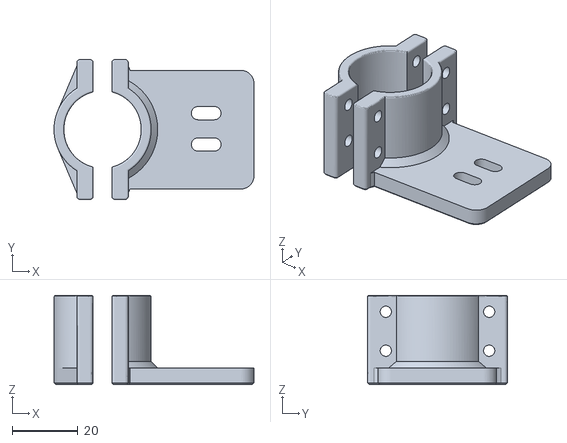
[picture p40: CAD file, 2016-02-14]
stl/etcs/MPCNCdragchainZclip.stl
60.6 x 42.5 x 27.0
