PingguSoft/Mostly-Printed-CNC/stl/IE_Middle_Joiner_25_V2.STL

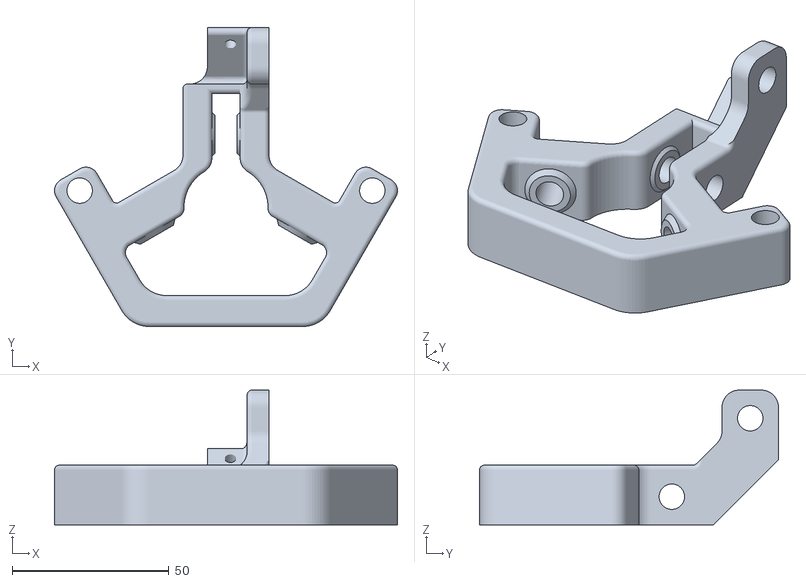
[picture p41: CAD file, 2015-11-30]
stl/IE_Middle_Joiner_25_V2.STL
109.4 x 95.3 x 43.0
