PingguSoft/Mostly-Printed-CNC/stl/universal holder/TKY_MPCNC_UniversalMount_Mk8_slider.stl

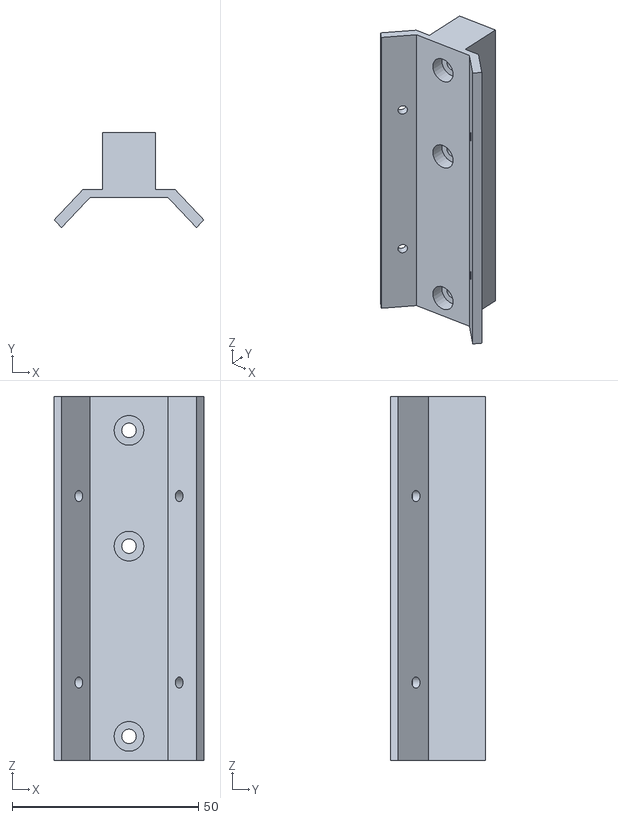
[picture p42: CAD file, 2016-01-20]
stl/universal holder/TKY_MPCNC_UniversalMount_Mk8_slider.stl
40.1 x 25.6 x 97.6
