PingguSoft/Mostly-Printed-CNC/stl/etcs/MPCNCdragchainXclip.stl

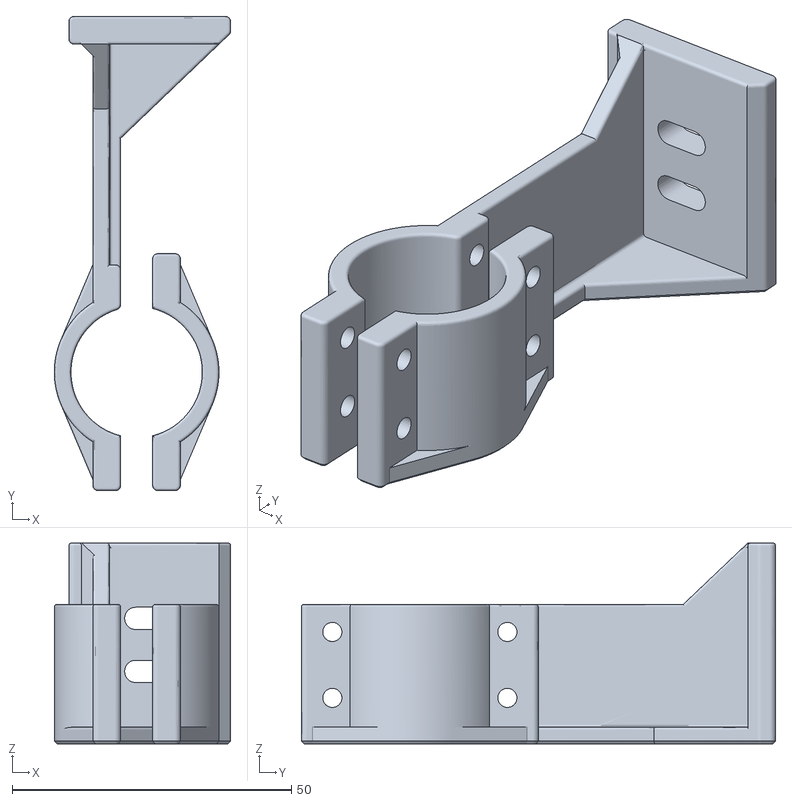
[picture p43: CAD file, 2016-02-14]
stl/etcs/MPCNCdragchainXclip.stl
31.6 x 85.0 x 36.0
