PingguSoft/Mostly-Printed-CNC/stl/IE_Tool_Holder_13mm_25.stl

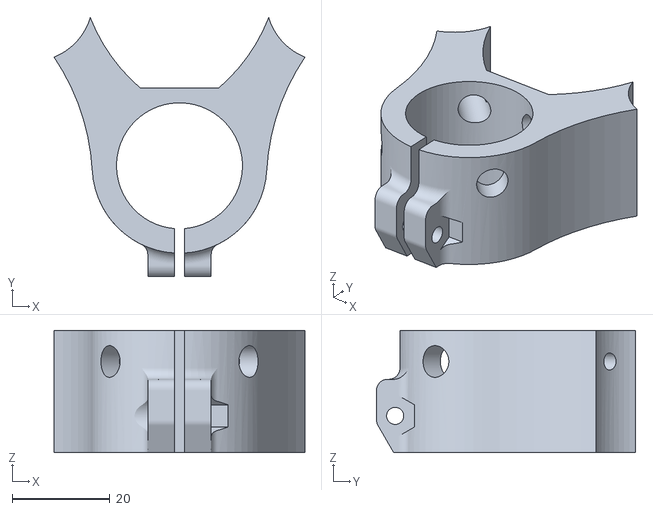
[picture p44: CAD file, 2015-11-30]
stl/IE_Tool_Holder_13mm_25.stl
51.4 x 53.1 x 25.0
