PingguSoft/Mostly-Printed-CNC/stl/universal holder/TKY_MPCNC_UniversalMount_Mk8_bracket.stl

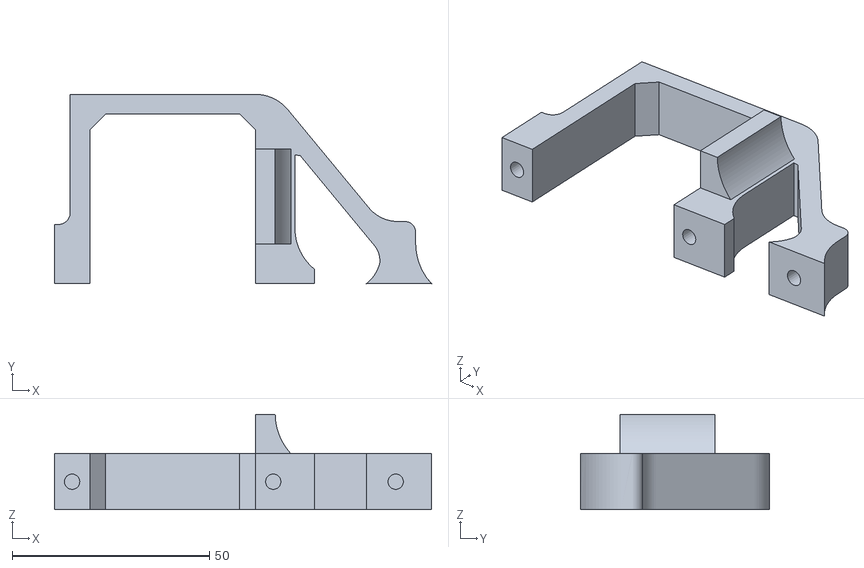
[picture p45: CAD file, 2016-01-20]
stl/universal holder/TKY_MPCNC_UniversalMount_Mk8_bracket.stl
95.6 x 48.0 x 24.2
