PingguSoft/Mostly-Printed-CNC/stl/etcs/MPCNCdragchainZshelf.stl

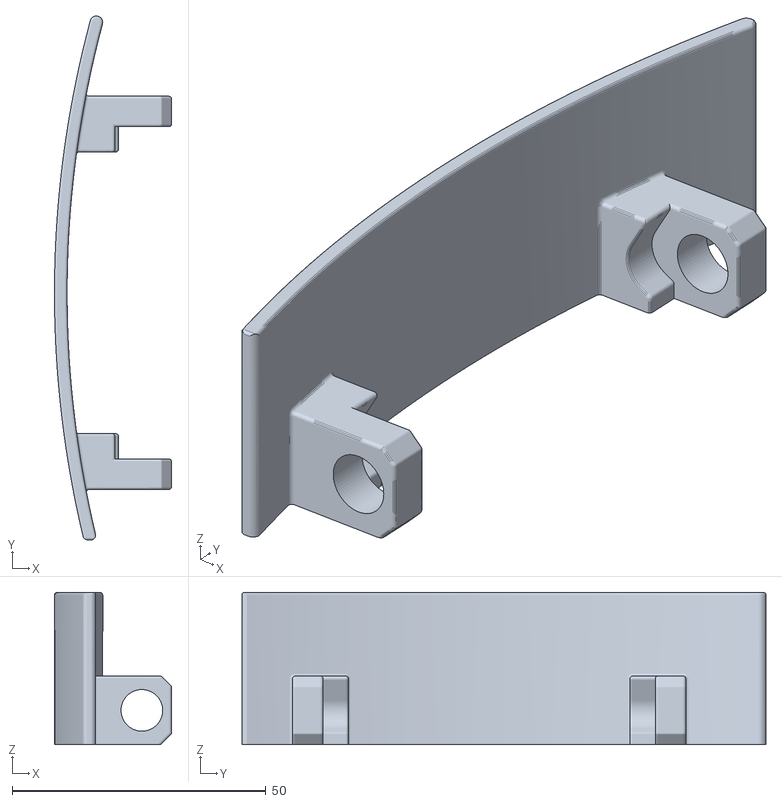
[picture p46: CAD file, 2016-02-14]
stl/etcs/MPCNCdragchainZshelf.stl
23.1 x 103.3 x 30.0
