PingguSoft/Mostly-Printed-CNC/stl/universal holder/IE_Universal_Mount_v5.stl

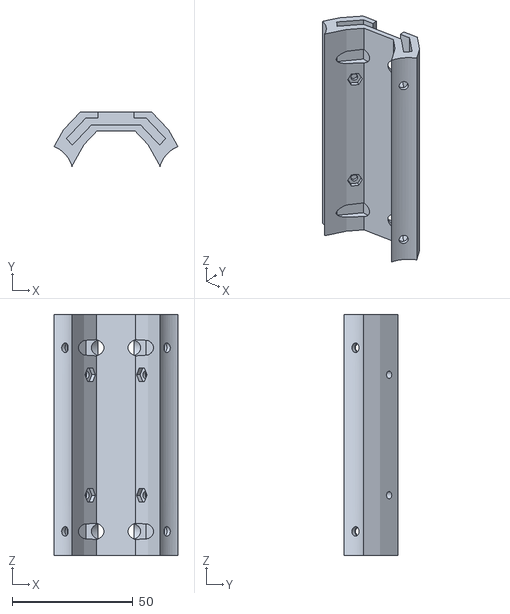
[picture p47: CAD file, 2016-01-20]
stl/universal holder/IE_Universal_Mount_v5.stl
51.4 x 22.5 x 100.0
