PingguSoft/Mostly-Printed-CNC/stl/etcs/ClipOnZForWire.stl

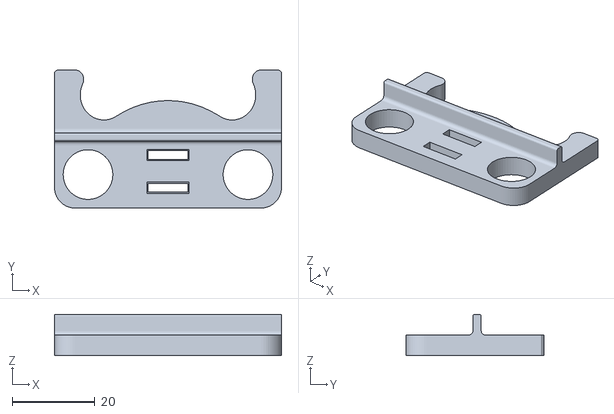
[picture p48: CAD file, 2016-02-14]
stl/etcs/ClipOnZForWire.stl
54.9 x 33.4 x 10.0
