PingguSoft/Mostly-Printed-CNC/stl/etcs/MPCNCdragchain.stl

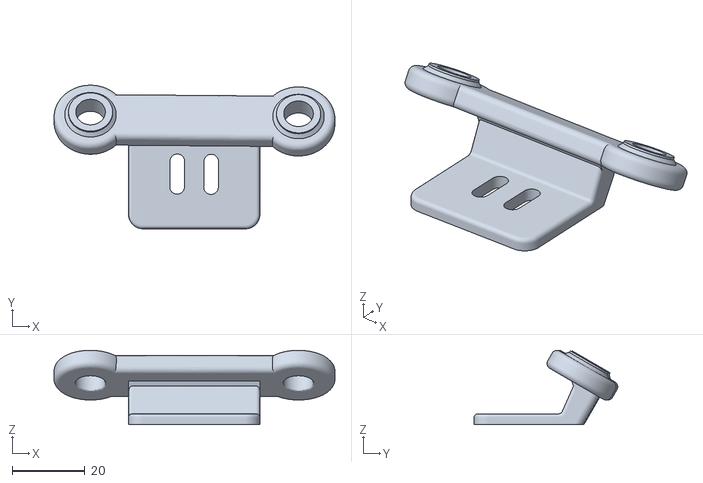
[picture p49: CAD file, 2016-02-04]
stl/etcs/MPCNCdragchain.stl
77.0 x 39.4 x 20.4
