PingguSoft/Mostly-Printed-CNC/stl/IE_Rigid_Coupler_5_16_to_8mm.STL

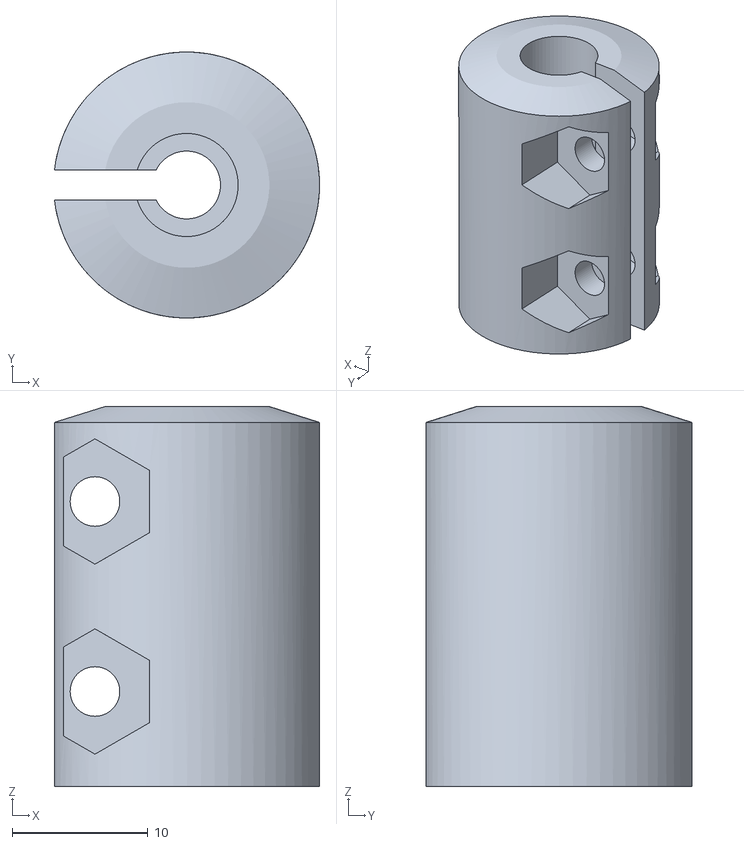
[picture p50: CAD file, 2015-11-30]
stl/IE_Rigid_Coupler_5_16_to_8mm.STL
19.5 x 19.6 x 28.0
