PingguSoft/Mostly-Printed-CNC/stl/etcs/mods_for_display_case_button.stl

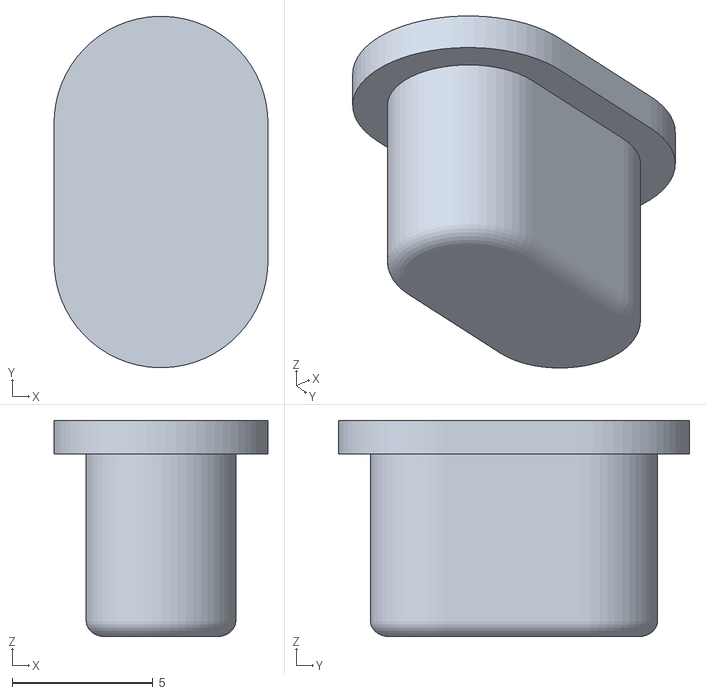
[picture p51: CAD file, 2016-01-26]
stl/etcs/mods_for_display_case_button.stl
7.60 x 12.5 x 7.68
