PingguSoft/Mostly-Printed-CNC/stl/IE_Corner_Block2.STL

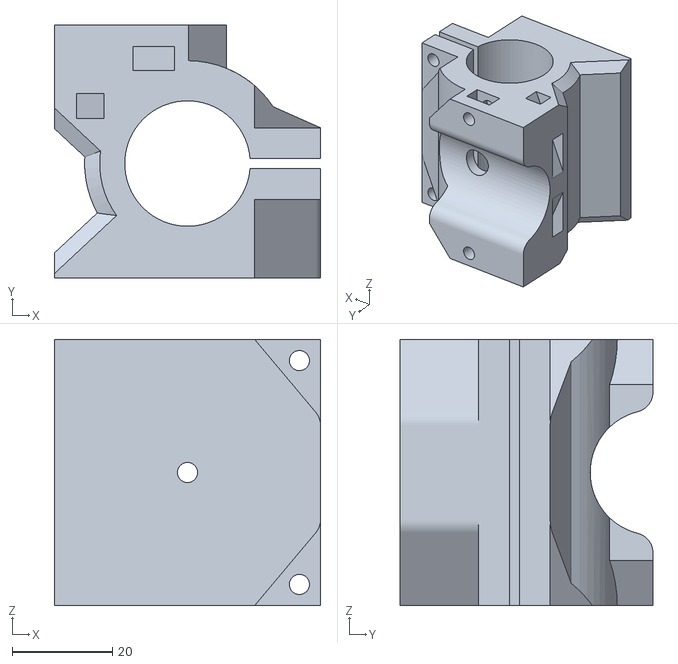
[picture p52: CAD file, 2015-11-30]
stl/IE_Corner_Block2.STL
53.0 x 50.4 x 53.0
