PingguSoft/Mostly-Printed-CNC/stl/etcs/IE25mm-A-endstops_XY.stl

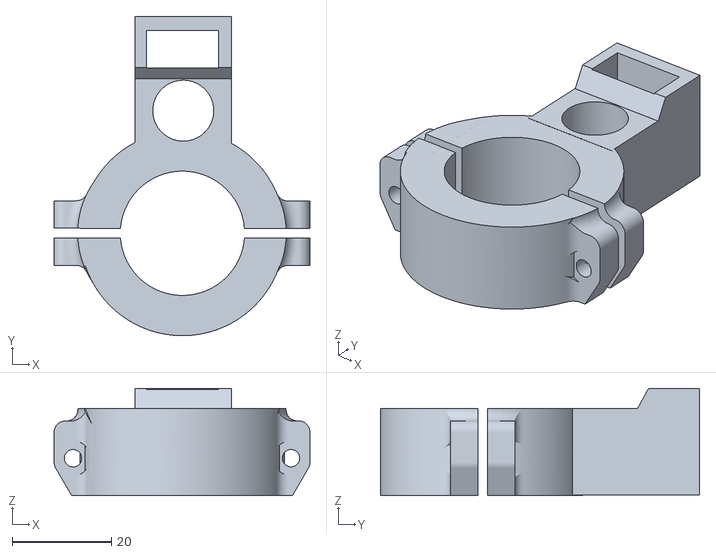
[picture p53: CAD file, 2016-01-26]
stl/etcs/IE25mm-A-endstops_XY.stl
51.5 x 64.2 x 21.5
