PingguSoft/Mostly-Printed-CNC/stl/IE_Middle_End_25_v2.STL

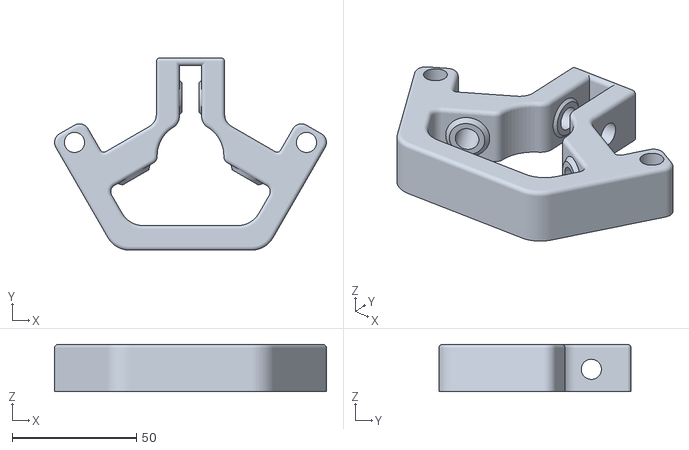
[picture p54: CAD file, 2015-11-30]
stl/IE_Middle_End_25_v2.STL
109.4 x 77.3 x 19.0
