PingguSoft/Mostly-Printed-CNC/stl/etcs/IE25mm-B-endstops_Z.stl

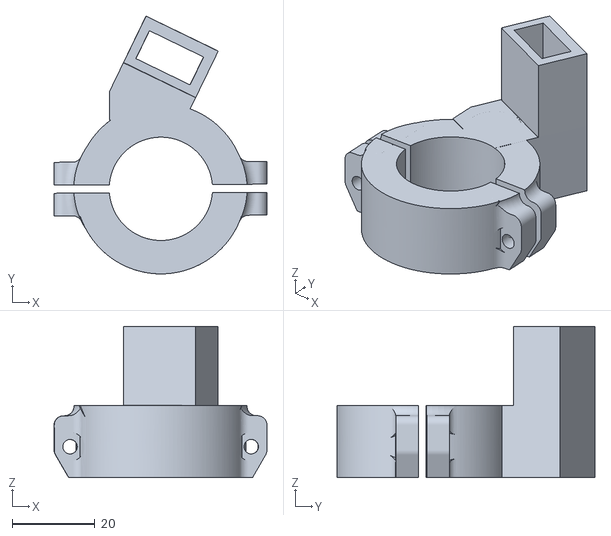
[picture p55: CAD file, 2016-01-26]
stl/etcs/IE25mm-B-endstops_Z.stl
51.6 x 62.4 x 36.7
