PingguSoft/Mostly-Printed-CNC/stl/IE_Roller_F_25.stl

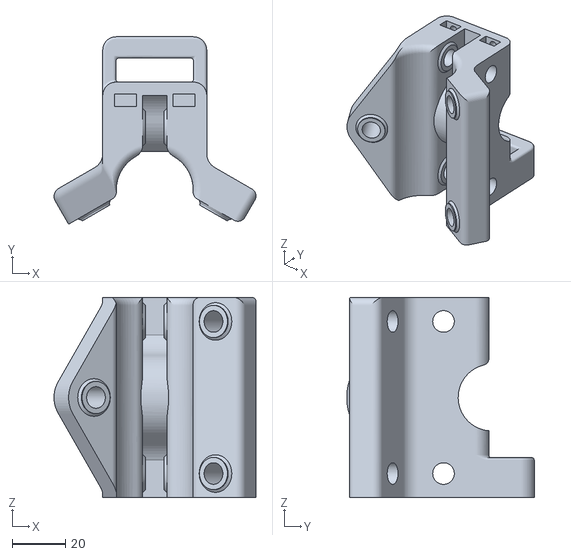
[picture p56: CAD file, 2015-11-30]
stl/IE_Roller_F_25.stl
75.7 x 70.3 x 75.0
