PingguSoft/Mostly-Printed-CNC/stl/etcs/mods_for_display_case_back.stl

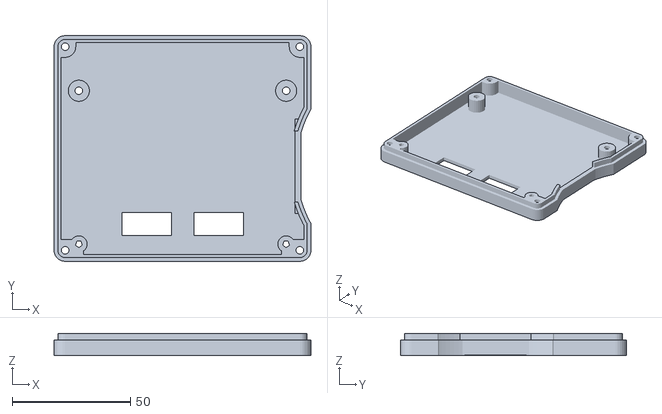
[picture p57: CAD file, 2016-01-26]
stl/etcs/mods_for_display_case_back.stl
108.6 x 95.4 x 9.37
