PingguSoft/Mostly-Printed-CNC/stl/etcs/mods_for_display_case_front.stl

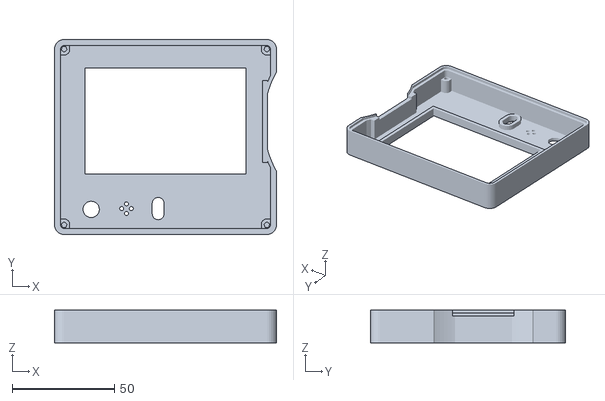
[picture p58: CAD file, 2016-01-26]
stl/etcs/mods_for_display_case_front.stl
108.6 x 95.4 x 16.1
