PingguSoft/Mostly-Printed-CNC/stl/IE_Corner_Block_Lock_2.STL

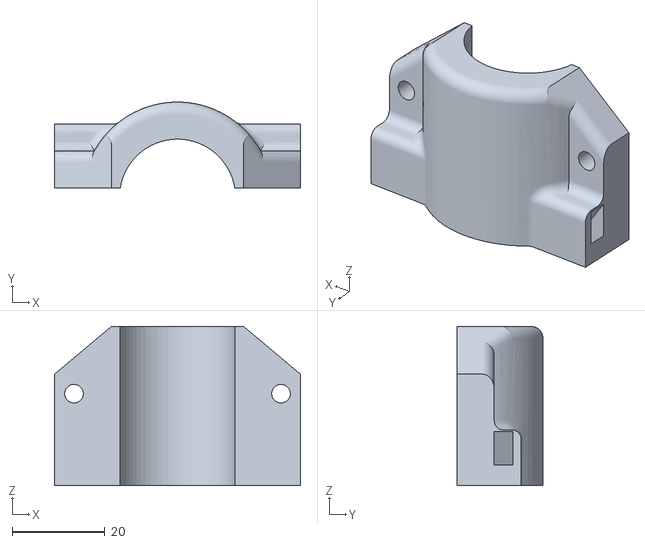
[picture p59: CAD file, 2015-11-30]
stl/IE_Corner_Block_Lock_2.STL
53.0 x 18.5 x 34.3
