PingguSoft/Mostly-Printed-CNC/stl/etcs/belt_clip_cover.stl

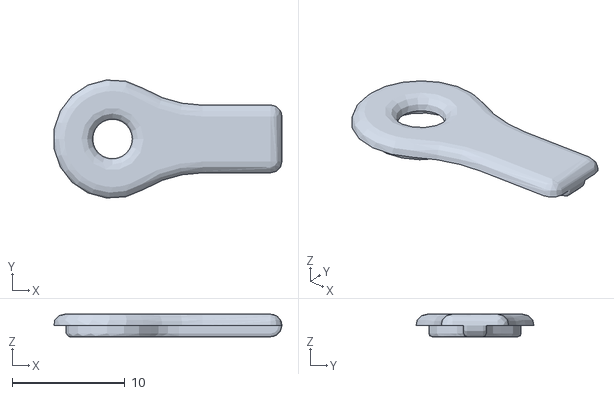
[picture p60: CAD file, 2016-01-24]
stl/etcs/belt_clip_cover.stl
20.2 x 10.4 x 2.00
