PingguSoft/Mostly-Printed-CNC/stl/etcs/belt_clip_body.stl

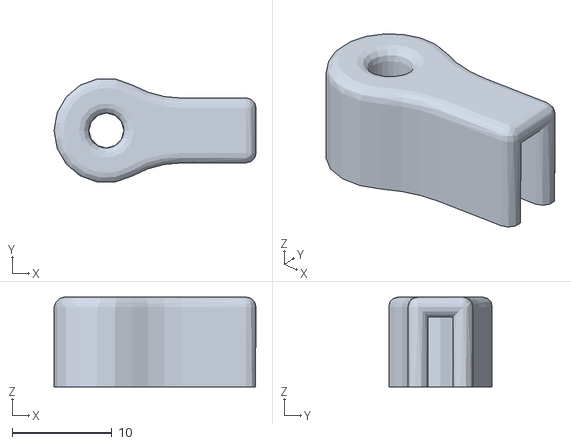
[picture p61: CAD file, 2016-01-24]
stl/etcs/belt_clip_body.stl
20.2 x 10.3 x 9.00
