PingguSoft/Mostly-Printed-CNC/(list of files, cad)

Other CAD files:
stl/IE_Tool_Holder_Nut_Trap_25.stl
stl/IE_z_nut_lock_13mm.stl
stl/IE_z_nut_lock_smaller_coupler_11mm.STL
stl/speed and fender washer combo.STL
stl/spool/nut.stl
