PingguSoft/Mostly-Printed-CNC/(commit log)

2015-11-24 initial update
    [parts.xlsx]
2015-11-30 folder rearrangement
    [IE_Corner_Block2.STL, IE_Corner_Block_Lock_2.STL, IE_Middle_End_25_v2.STL, IE_Middle_Joiner_25_V2.STL, IE_Middle_Z_25.stl, IE_Rigid_Coupler_5_16_to_8mm.STL, IE_Roller_F_25.stl, IE_Tool_Holder_13mm_25.stl]
2016-01-13 STL updated
    STL updated and CALC tool added
    [IE-Flex_Foot.STL, IE_Foot_Bottom.stl, IE_Middle_Z_25.stl, IE_Middle_Z_rigid_v2.STL, IE_z_motor_mount_10mm_longer_25mm.STL, IE_z_motor_mount_25.stl, Z_Knob.STL, parts.xlsx]
2016-01-13 conduit length calculation
    [parts.xlsx]
2016-01-14 wish list complete
    [parts.xlsx]
2016-01-20 universal holder added
    [IE_Universal_Mount_v5.stl, Pen_Adapter_10.5mm.stl, Pen_Holder_v4.stl, TKY_MPCNC_UniversalMount_Mk8_bracket.stl, TKY_MPCNC_UniversalMount_Mk8_slider.stl, parts.xlsx]
2016-01-21 universal holder folder added
    [IE-Flex_Foot.STL, IE_Foot_Bottom.stl, IE_Universal_Mount_v5.stl, Pen_Adapter_10.5mm.stl, Pen_Holder_v4.stl, TKY_MPCNC_UniversalMount_Mk8_bracket.stl, TKY_MPCNC_UniversalMount_Mk8_slider.stl, parts.xlsx]
2016-01-22 parts are updated
    [Dremel300_Bottom_w_Mount.stl, Dremel300_UpperBracket.stl, parts.xlsx]
2016-01-24 src and belt clip added
    [Configuration.h, Configuration_adv.h, belt_clip_body.stl, belt_clip_cover.stl, parts.xlsx]
2016-01-24 belt clip added
    [parts.xlsx]
2016-01-26 motor step and knob direction changed
    [Configuration.h, IE25mm-A-endstops_XY.stl, IE25mm-B-endstops_Z.stl, belt_clip_body.stl, belt_clip_cover.stl, mods_for_display_case_back.stl, mods_for_display_case_button.stl, mods_for_display_case_front.stl]
2016-01-27 connection diagram and plotter tool added
    [Configuration.h, parts.xlsx]
2016-01-28 proximity sensor holder added
    [proximity_sensor_holder.stl]
2016-02-01 laser module added
    [parts.xlsx]
2016-02-02 3dpburner added
    [parts.xlsx]
2016-02-02 holder added
    [Configuration.h, proximity_sensor_holder2.stl]
2016-02-04 laser holder added
    [Offset10mm_Maxi_Mount_v2.stl, Std_Mini_Mount_v4.stl, parts.xlsx]
2016-02-04 drag chain holder added
    [MPCNCdragchain.stl, parts.xlsx]
2016-02-05 3mm expansion
2016-02-14 3d printer test
    [ClipOnZForWire.stl, Configuration.h, MPCNCdragchainXclip.stl, MPCNCdragchainZclip.stl, MPCNCdragchainZshelf.stl, parts.xlsx]
2016-02-15 support pipes are added
    [parts.xlsx]
2016-02-22 change Z axis to T8 lead screw
    [Configuration.h, parts.xlsx, proximity_sensor_holder.stl, proximity_sensor_holder2.stl]
2016-02-22 several designes are added
    [Felix_E3DV5_fan_duct_V2.stl, mpcnc_square_check_rev1_20160212-15074-5me4b8-0.stl, sensor_holder_all.stl, spool_holder.stl]
2016-03-08 cable connector holder added
    [connector_holder_base.stl, connector_holder_top.stl]
2017-01-20 z working area reduced
    [2016_spool.stl, nut.stl, parts.xlsx, pipe_cap_for_25mm.stl]
2017-01-23 z height adjusted to 140
    [parts.xlsx]
